MarkusLoew/OzFluxtowerhandbook/README.md

# OzFlux tower handbook
A technical guide on setting up an eddy covariance tower
