MarkusLoew/OzFluxtowerhandbook/Communication.md

# Communication

## Direct communication with a data logger

In the simplest case, communication with a logger can be done directly, by connecting a computer to the logger and downloading the data and uploading/changing programs and settings manually. This method is straightforward but requires physical access to the logger.

### Serial communication

Many modern computers don't have a serial port any more, so a USB-to-serial adapter is required. Recommended serial-to-usb adapter (known to also allow complex serial operations like firmware upgrades of a Li6400):

[FTDI Chip model US232R-10 usb to RS232](https://ftdichip.com/products/us232r-10-bulk/)

Available via e.g.

-   [recommended FTDI Chip RS232 USB to serial converter, RS-online](https://au.rs-online.com/web/p/interface-adapters-converters/0429274)

-   [Li-COR USB-to-serial connector](https://shop.licor.com/env/store/product?c=photoextra&n=6400-27)

After connecting the converter to your computer, check your computer settings what serial port the adapter is using (e.g. COM7). Windows: check "`Device manager`", section "ports" Windows port-assignments can change depending on where the converter is plugged in. For Linux: check `ls /dev/tty*` for new devices e.g. `ttyUSB0` or `ttyACM0`.

The newer generation Campbell Scientific (CR310, CR6, CR1000x) and other manufacturer's loggers have built in USB-to-serial converters. No dedicated serial cable and plug are required for those, a USB cable is sufficient to connect. The communication protocol is still RS232 and it is still required to know what serial port on the computer side is used for communication.

Li-Cor uses a null-modem / cross-over cable to communicate with their devices, while Campbell Scientific uses a straight-through serial cable. These cables are not compatible!

![Varius serial cables: Campbell Scientifc-compatible serial cable with FTDI US232R-10 USB-to-serial converter (grey cable, blue white USB-to-serial converter), Li-Cor-compatible Null-modem serial cable with self-made serial LI-7500 irga serial adapter cable (light grey, green plug). USB cables with USB-A to USB-Micro A (black, suits CR6, CR310, CR1000x) and USB-A to USB-C (white, suits CR1000xe). CR1000 data logger with serial port only. CR310 data logger with serial port, USB-MicroA port, and ethernet plug (Markus Loew).](images/communication/communication_serial_cables.jpg)

-   Campbell-Scientific-compatible *straight-through* *serial cable* for Campbell Scientific loggers and instruments, CR1000, CR3000, CR310, CR10x, ... e.g.: [Male D-Sub 9-Pin to Female Serial Cable](https://au.rs-online.com/web/p/serial-cables/1828782)

-   Li-Cor compatible *null-modem / cross-over cable* (for e.g. Li-7500xxx, Li-6400, Li-810) [Female D-Sub 9-Pin to Female D-Sub Modem Cable](https://au.rs-online.com/web/p/serial-cables/2863537)

**The two cable types are incompatible** out of the box! The cable-internal wiring is different between the cable types, but not necessarily the plug configuration! (Also: Plug-converters exist). A null-modem cable has pins 2 and 3 swapped between the two ends of the cable. Check electrical continuity of the pins to determine the cable type!

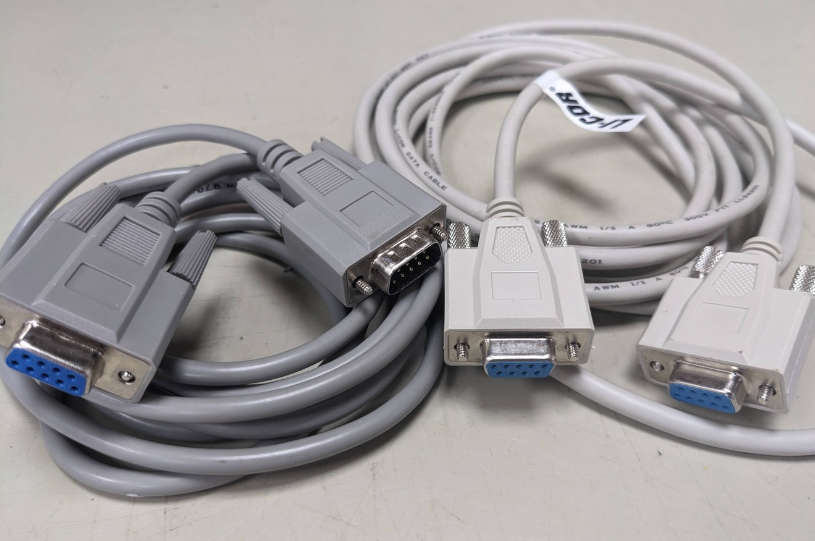
[picture p1: images/communication/serial_vs_null_modem_cable.jpg]
Serial cable for Campbell Scientific loggers, straight-through serial cable with male to female 9-pin plugs (left). Li-Cor compatible cross-over null-modem cable with female-to-female plug (right) (Markus Loew).


## Modem

If a site has reasonable 4G/5G coverage, a modem can used for data transmission [(Telstra coverage map)](https://www.telstra.com.au/coverage-networks/our-coverage). In Australia, the recommended - and frequently the only - phone network for remote locations is Telstra. TERN EP provides data-only Telstra SIM cards on request. Some towers might not require a 4G modem at all if there is an alternative internet connection (WiFi, DSL, fibreoptics, fixed-wireless, satellite, ...) readily available. Then a router will suffice (see below).

### 4G modem options

Selection criteria for modems:

-   Operating voltage: The modem must be able to operate using the available voltage(s) to avoid conversions. Many industrial modems allow 9 to 36V DC input power - Make sure the voltage of your power supply is compatible at your tower site.

-   Operating temperature: The modem must be able to operate within the anticipated temperature range of a research location. E.g. -20°C to 50°C.

-   Form factor: Chose a modem that fits in the available enclosure space, especially if all loggers and network devices must fit an a single enclosure. Modems that can be mounted vertically on a DIN rail allow to save space and use the "height" of the enclosure. Many modems offer DIN rail mounts, but some have the rail mount in a location so that it can not be installed in space-saving way. Then adapters might be required.

Recommendations for **industrial-grade modems**:

-   [Maxon Quadmax MA-6060](https://rfi-sb.rfi.com.au/MA-6060) Slim-line modem, dual SIM slots, four ethernet ports, dual 4G antennas, two WiFi antennas, DIN rail on the thin side. Has built-in analog relay to devices like e.g. phenocam. Capable to connect to OpenVPN, and similar services.

-   [Maxon Dualmax MA-2055](https://rfi-sb.rfi.com.au/MA-2055) Flat, but slightly wide modem, dual SIM slots, two ethernet ports, dual 4G antennas, no WiFi (!), DIN rail on the wide side (not space-saving out of the box, but custom angle bracket available, see below). Capable to connect to OpenVPN, and similar services. See [setup notes for this modem here](./TERNOpenVPN.md).\
    While the dualmax modem comes with a DIN-rail mount on the back, it uses quite a bit of space in an enclosure. Here is a 3D-printed angle mount that suits the 2.54 cm grid pattern of Campbell Scientific enclosures. This allows the Dualmax modem to be mounted flat or vertical to save space ([see photo](./Sensorwiring.html#wiring-information)).\
    [Download modem angle bracket mount, STL 3D print file](./downloads/Dualmax_modem_panel_mount_Loew.stl "STL file download") (Markus Loew).

-   [Robustel R1520](https://www.rfi.com.au/R1520) Wide modem, but rather small size, dual SIM slots, four ethernet ports, dual 4G antennas, WiFi, DIN rail on the wide side. Capable to connect to OpenVPN, and similar services. ***!!There are unresolved issues with this modem and the TERN OpenVPN encryption, unfortunately!!***

-   [Comset CM685V-4](https://comset.com.au/product/4g-lte-cat-4-wifi-router-with-sim-card-slot-cm685v-4/) 4G LTE Cat 4 WiFi router with SIM card slot. Quite compact form factor. This modem operates on the powerful OpenWRT OS and provides an OpenVPN client, MiMo antenna linking, 2 ethernet ports, and WiFi. Melbourne-based company.

-   [Belden Netmodule 1601](https://www.belden.com/products/industrial-networking-cybersecurity/wireless/iiot-and-industrial-routers/nb1601-lsc) Slim-line modem, dual SIM slots, four ethernet ports, dual 4G antennas, two WiFI antennas, DIN rail on the thin side. Has built-in analog relay to devices like e.g. phenocam. Capable to connect to OpenVPN, and similar services.

-   [Teltonika RUT951](https://www.telcoantennas.com.au/teltonika-rut951) Dual antenna, dual SIM modem with three ethernet ports. OpenWRT-based. BEware of the Molex 4-pin power plug! See [Teltonika power options](https://www.teltonika-networks.com/products/accessories/powering-options), [4-way Molex power plug](https://www.digikey.com.au/en/products/detail/molex/0430250400/252497), and [plug accessories](https://www.digikey.com.au/en/product-highlight/m/molex-connector/micro-fit-3-interconnect-system). The DIN rail is sold separately.

-   [Campbell Scientific Cell220](https://www.campbellsci.com.au/cell220) Serial modem well integrated the the Campbell Scientifc logger ecosystem. The Modem is conveniently configured via the logger program (CRBasic). This modem can interact directly with logger, and data and provides diagnostic output (like signal strength, uptime) to data tables on the logger. Modem actions can be triggered depending on logger or measurement status. No WiFi, no ethernet ports, dual antenna, single SIM card. Small form factor, highly configurable. Similar serial modems are available elsewhere too, as long as they support he full range of AT modem commands (ie Netmodule NB1600).

Note: As TERN EP provides **data-only SIM cards**, any monitoring and feedback-options of the modems that rely on SMS text messages will not work! There is no "phone" quota associated to these SIM cards. E.g. the Quadmax modem can not send a warning SMS when switching from primary to the secondary SIM card when the primary card fails! And any IP-address monitoring and dial-in options that these modems provide (e.g. direct dial-in in case OpenVPN fails), don't work with data-only cards either.

It is highly **recommended to set up the modems to reboot themselves regularly!** This ensures that the modem can recover from any temporary network issues. Network congestion can be temporary: holiday-makers in a nearby campsite or a music festival in the area of the tower can "overload" the 4G network, or the Telstra-network tower can be offline for maintenance. Once these issues are resolved, the tower will be come back online by itself after the next reboot. After a 4G network outage, not all modems keep trying to re-connect to the network. E.g. the Maxon modems only try five times and then then stop. Re-booting the modem resets this counter and the modem will connect again. Hence, set up scheduled reboot either daily or weekly. Set a conventient time of day that does not interfere with data collection or other critical operations.

From experience with **operating towers in bad or sometimes congested mobile phone networks** (Whroo, Boolcoomatta), the modem can come back online for at least a few minutes after an automated reboot even in a low bandwidth or congested situation before the connection drops out again. If the daily (or weekly) reboot is scheduled at a time with less network congestion (night time, weekend), the modem might be online again, at least temporarily. This allows to check on signal strength in the modem (to see if the antenna might be damaged, cable broken, ...), and allows to check logger program settings, or delete faulty files from the storage card.

Turning off the upload of 10/20 Hz flux data can help "clean the airwaves" to allow the much smaller 30 min average data tables to be uploaded despite congestion. A specific logger program for low bandwidth situations is available as the *Boolcoomatta logger program* (Markus Loew) from [OzFlux logger code repository](https://github.com/OzFlux/logger_code) (Ian McHugh). This program has options in the *Public* table to change the upload format of the 10/20 Hz data (choice between compressed, small TOB1 files, or ASCII, easy-readable but uncompressed TOA5 files.) And it allows to not upload the fast data at all to save bandwidth and upload time. Having these options in the *Public* table allows to change file- and upload-related settings without risking sending a new program over a bad internet connection.

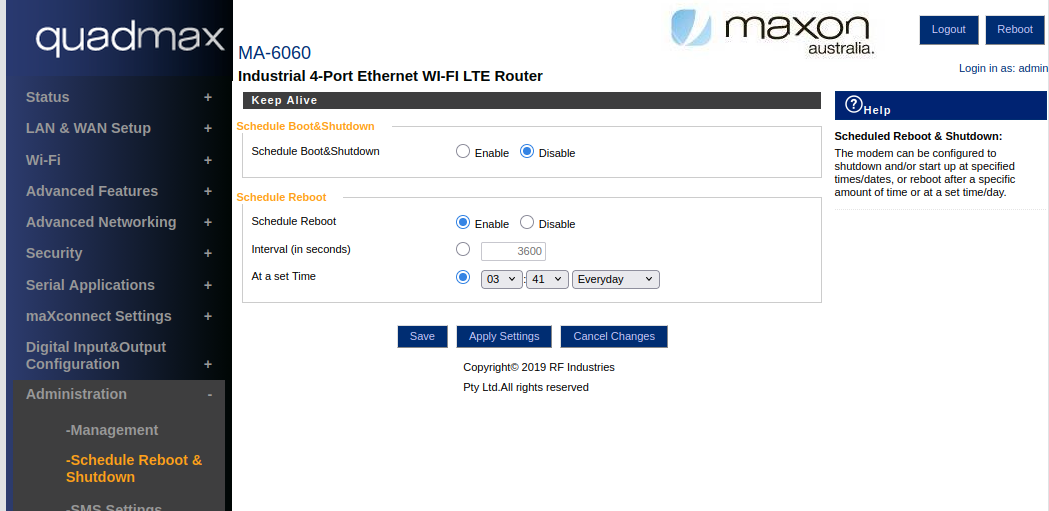
[picture p2: images/communication/modem_regular_reboot.png]
Schedule reboot options in the settings of a Maxon Quadmax modem. The modem will reboot itself every day at 03:41 (Markus Loew).


### Antennas

-   **Omnidirectional** (omni) antennas are "install and forget": they will connect to any phone network in the area, and can switch between multiple network towers depending on signal strength or if a phone tower goes offline.

-   **Directional** (yagi) antennas must be pointing to a known, specific network tower. This will improve the signal. The downside is, that the antenna points to a single tower. If that one network tower goes down, this antenna will not be able to connect to another tower.

In locations with marginal reception, it is recommended to use a modem that allows the use of **two antennas, preferably yagi, in parallel (MiMo)**. Both antennas must be pointing to the same phone network tower (!), and must be about 50 cm apart vertically for optimal signal boost.

-   [BlackHawk Directional antenna, MiMo capable](https://blackhawkantennas.com.au/product/blackhawk-lpda-antenna/) You need two of these antennas for MiMo operation!
-   [Comset Directional antenna, 4x Yagi antenna MiMo capable](https://comset.com.au/product/5g-mimo-4x4-lpda-antenna-3g4g5g-10-m-ant-yagi-4x4-10sp/)
-   [Phased Array Yagi Kit](https://www.telcoantennas.com.au/ultimate-antenna-kit-19dbi-rfi-phased-yagis) for maximum distance.
-   [ZCG Scalar directional antenna](https://zcg.com.au/product/broadband-uhf-4g-lte-and-dualband-4g-log-periodic-antenna-304-stainless-steel-650-2250-mhz-250w-n-type-female-10-2-dbi-1-15m-4/)
-   [ZCG Various antenna mounts](https://zcg.com.au/catalogue/mobile-vehicle-mount/)

When designing the tower and instrumentation location on the tower, keep in mind that **standard antenna cables can only be 10 m long** before significant signal degradation occurs. Hence, the modem must be close to the antenna! See section anttenna cable length limitation below.

### Antenna cable length limitation

Cables between a 4G modem and a 4G antenna should not be longer than 10 m! Longer cables can cause significant (logarithmic?) signal degradation, reducing the effectiveness of the antenna setup. For tall towers, this means that the modem must be on top of the tower, out of reach of easy access, to be close to the antenna. This can be a problem for maintenance and troubleshooting. For towers up to 10 m tall, the modem can be inside the data logger and power enclosure (see e.g. Boolcoomatta tower) making it a compact and accessible setup.

If a \<10 m modem cable is not an option at all:

For **longer antenna-to-modem distances**, beyond 10 m, but less than 30 m, one could try a eg [Ultra Low Loss Flexible Coaxial Cable](https://www.telcoantennas.com.au/telco-antennas-lcu600-ultra-low-loss-flexible-coax~87862).

### Check for available towers in your area on these websites:

-   [RFNSA Radio Frequency National Site Archive](https://www.rfnsa.com.au/)

-   [ACMA map](https://web.acma.gov.au/rrl/site_proximity.main_page)

-   [Ausphonetowers](https://ausphonetowers.com.au/)

To determine line of sight between a phone tower and your location:

-   [Hey What's That (Line of sight map, panorama)](https://www.heywhatsthat.com/)
-   [Incoherency Line of Sight Map](https://incoherency.co.uk/line-of-sight-map/)
-   [Scadacore RF Line of Sight](https://www.scadacore.com/tools/rf-path/rf-line-of-sight/)

Phone apps to check signal status and cell tower locations:

-   [SignalStrength App](https://play.google.com/store/apps/details?id=com.cls.networkwidget&hl=en_AU)

-   [Opensignal apps](https://www.opensignal.com/apps) Opensignal seems to use community sourced phone tower locations. The websites listed above provide a more comprehensive list of towers.

#### Checking and optimising 4G connectivity, antenna direction

Neither of the above antenna-map websites can guarantee that there will be reception at the location! A fieldtrip with modem and antenna(s) and a long pole is usually required to check connectivity. If there is marginal 4G coverage, it is about optimising the available signal.

Check signal strength:

-   4G signal strength is measured in decibel, dB(m). For details on RSSI, RSRQ, RSRP, and SINR metrics see: <https://wiki.teltonika-networks.com/view/Mobile_Signal_Strength_Recommendations>

-   The tested modems above display the 4G signal strength in their "Status" or "WAN" management website. This is commonly named "RSSI" and displayed in dB(m). Less negative RSSI values indicate higher signal strength in general. For caveats regarding RSSI see <https://wiki.teltonika-networks.com/view/Mobile_Signal_Strength_Recommendations>

-   Phones can be used as a quick way to check connectivity, Apps like "Signalstrength" give more details than the usual "number of bars". However, the physically small internal antennas are no match for dual, directional antennas! It is possible to establish a well working connection with largeer antennas when a phone shows zero "bars". Size matters!

-   Use two antennas in MiMo mode. This can boost signal strenght by 30 to 50% from experience (Note that the RSSI scale is logarithmic). \* Point the antennas in the direction of known phone towers (use the websites listed above to see maps of available towers). Wait for about one to three minutes and check the signal strength RSSI values displayed in your modem management interface. Then turn the antenna to sweep for a better / worse signal.

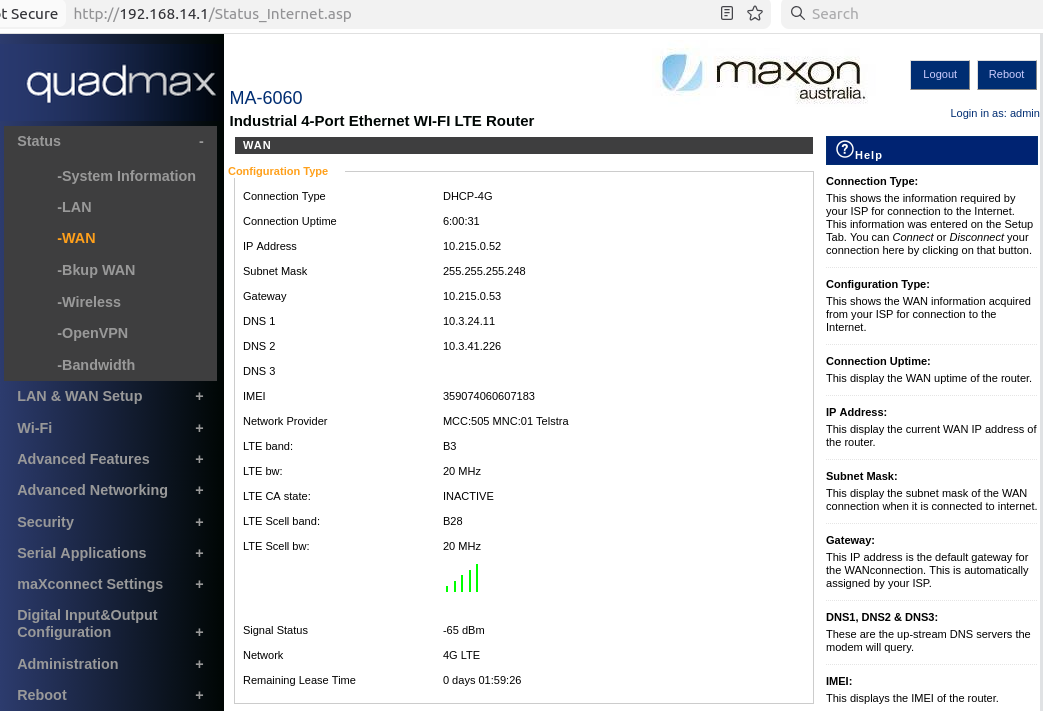
[picture p3: images/communication/Quadmax_signal_strength_screenshot_from_2026-04-10 09-18-24.png]
4G WAN status display of a Maxon Quadmax modem. See "Signal Status" of -65 dBm indicating good reception. This modem uses dual directional antennas. With a single, omnidirectional antenna, the signal strength at this tower was only marginal at -85 dBm (Markus Loew).


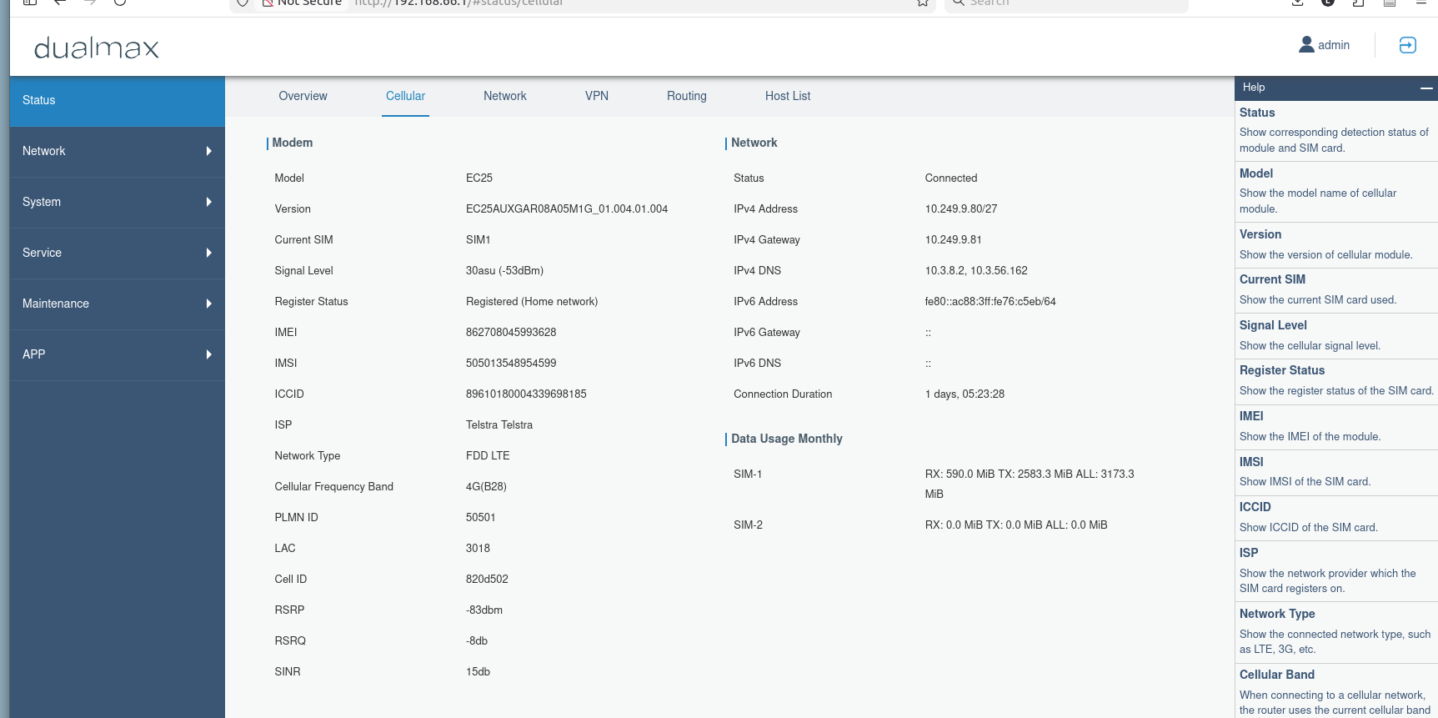
[picture p4: images/communication/Dualmax_signal_strength_screenshot_from_2026-04-10 09-19-27.png]
4G cellular status display of a Maxon Dualmax modem. Signal level of -53 dBm indicates an excellent signal status. This modem uses two small "indoor" antennas inside the enclosure. The tower is in a location with general good 4G network coverage, no large outdoor antennas are needed.


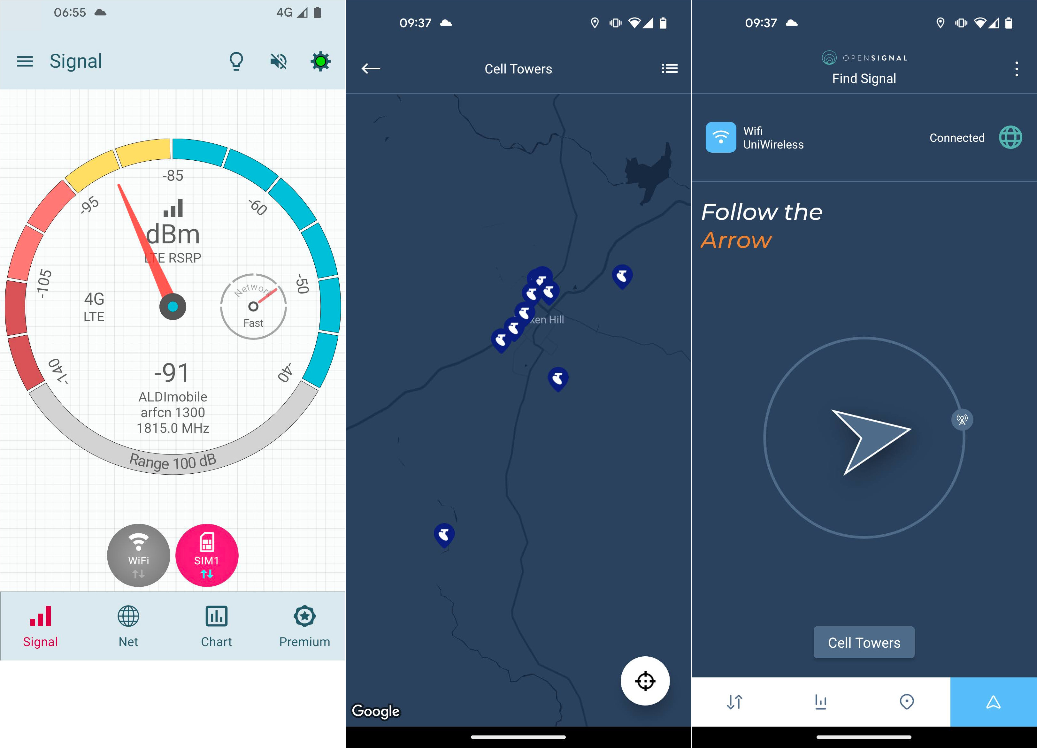
[picture p5: images/communication/signal_strength.jpg]
Signal strength display and tower location displays from two phone apps: "SignalStrength" (left), indicating marginal 4G reception and showing an overall classification of the the 4G signal strength range. Location of 4G towers mapped by the app "Opensignal" (middle), and direction indicator of the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


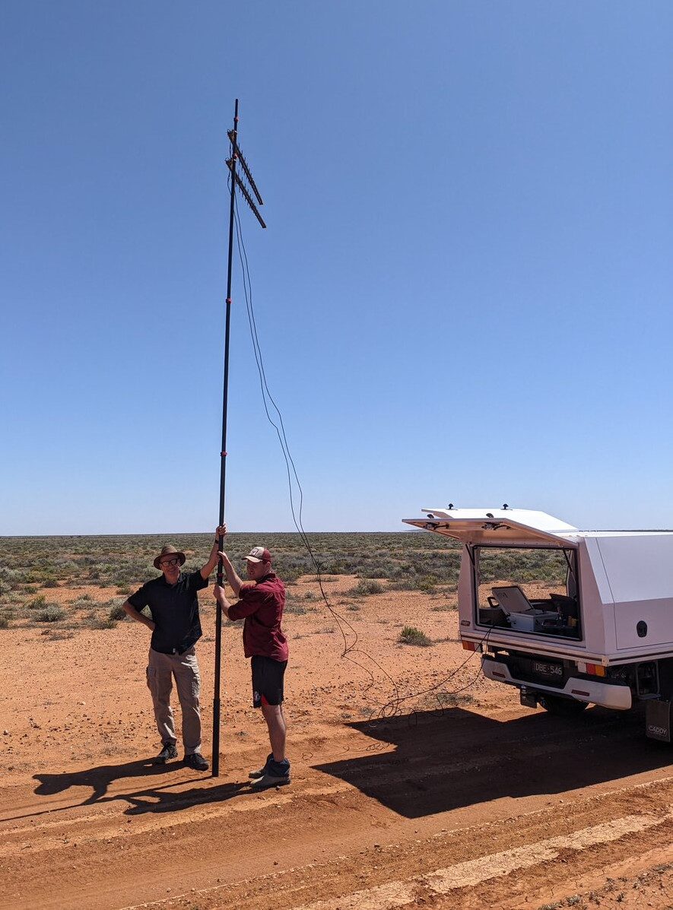
[picture p6: images/communication/checking_for_connectivity.jpg]
Checking and mapping 4G connectivity on location months before deciding on a location for the flux tower. Two directional mimo antennas on a telescopic pruning pole connected to a battery-powered Maxon Quadmax modem were used to test mobile network reception and data transmission bandwidth. A good 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


## Satellite communication

to do (Mark Hovenden?)

-   12V Starlink Mini

-   240V Starlink either via inverter or via 12V modification, POE injector? see below [Communication.html#poe-injectors](./Communication.html#poe-injectors)?

-   how to do TERN OpenVPN via limited, locked-down Starlink router? Daisy-chain quadmax-modem/router or similar behind Starlink router?

-   Power consumption during transmission?

-   Constant connectivity? Or interrupted depending on satellite availability, rain, leaves? Problem with disconnects?

## Router

Check if a modem provides sufficient ethernet ports (router functionality) for all the devices on the local tower network. Consider a modem with sufficient built-in ethernet ports. Avoid "office-grade" network routers. Check if what data transmission rates are required at a research tower. Chose a GBit capable-router if required (ie for high-frequency spectral data or similar high-volume data acquisition). Many industrial MBit-class routers offer sufficient performance for flux-related data transfer and are more robust.

### Router recommendations

Unmanaged-routers:

-   [Industrial 5-port 100 MBit router](https://www.brainboxes.com/product/industrial-ethernet-switches/fast-ethernet/sw-505) (5 to 30V, DIN rail mount)

-   [Industrial 8-port 100 MBit router](https://www.brainboxes.com/product/industrial-ethernet-switches/fast-ethernet/sw-508) (5 to 30V, DIN rail mount)

-   to do: recommendation for GBit networks?

General network routers like office-grade, indoor routers (e.g. Netgear) are known to be more susceptible to electrical interference (lightning, power surges) and do not operate well at extreme temperatures compared to "industrial" routers.

## Power over ethernet (POE) injectors

Some network devices like WiFi extenders, some phenocams, (Starlink?), require power-over-ethernet. This provides the power to operate the device via the ethernet cable.

As ethernet cables have a tiny diameter, voltage is boosted by the POE injector to cover large distances without voltage drop.

Some large POE-powered devices like the UniFi Outdoor 7 WiFi hub require POE+, ie 56V, to operate!

Be aware of power demands: The conversion from 12V to 48V or even 56V to operate a POE device is quite power-consuming.

Recommended 12V-operated POE injectors (<https://www.telcoantennas.com.au/>):

-   [POE 12V to 48V](https://www.telcoantennas.com.au/12vdc-to-48vdc-poe-passive-power-over-ethernet-inj)

-   [POE+ 12V to 56V](https://www.telcoantennas.com.au/12vdc-to-56vdc-poe-power-over-ethernet-injector)

## WiFi extenders

-   [UniFi AC Mesh](https://techspecs.ui.com/unifi/wifi/uap-ac-mesh?) Despite the name, it is powered by via POE. But it includes an injector for a 240V AC household outlet.
-   [TPlink EAP225 Outdoor](https://www.omadanetworks.com/au/business-networking/omada-wifi-outdoor/eap225-outdoor/)

There are stark similarities between the two models above.

[Home](./Home.html)
