MarkusLoew/OzFluxtowerhandbook/Phenocam.md

---
bibliography: ./references/References.bib # path and bibliography .bib file name
---

# Phenocams

## Phenocam models

### Campbell Scientific CCFC

Across the TERN OzFlux network, many sites are equipped with the [Campbell Scientific CCFC camera](https://www.campbellsci.com/ccfc).

This camera integrates well with the TERN network as it supports key-based sftp file upload via ssh to the TERN file storage and data portal automatically. It is extremely well built, it is its own wheaterproof housing, has a deep-sleep power mode of \< 6 mA, large built-in file storage, and has a simple configuration web interface. But it is rather expensive!

It is the **preferred model** for TERN-supported flux towers to ensure standardisation.

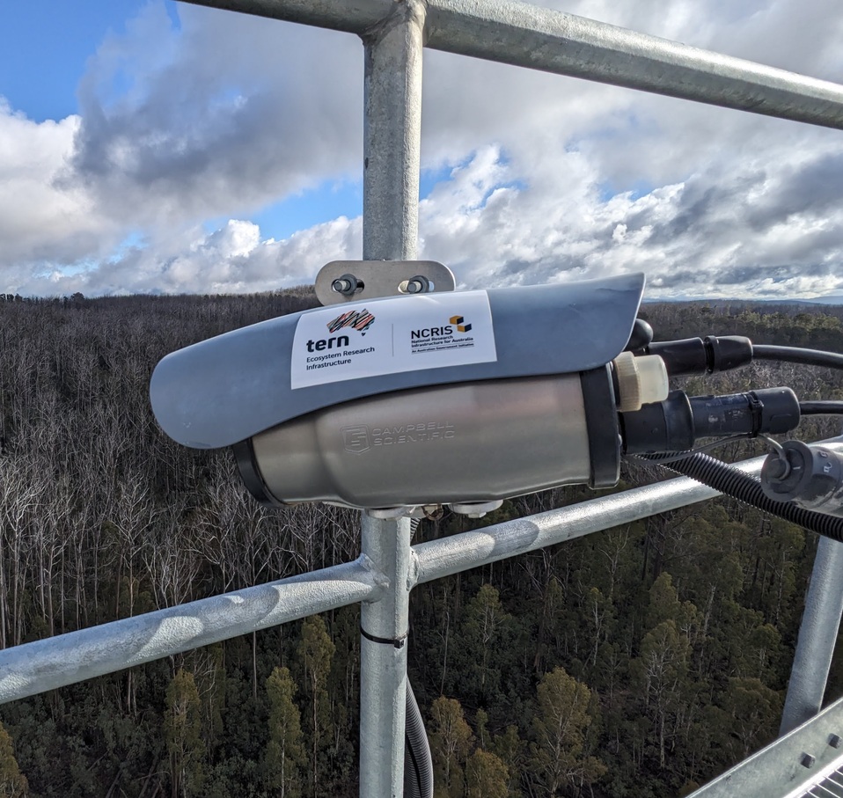
[picture p7: images/phenocam/Campbell_Scientific_CCFC_PXL_20260611_002924827.jpg]
Campbell Scientific CCFC phenocam on the Tumbarumba tower (Markus Loew). Custom mounting bracket provided by Nico Weigand.


In addition to the usual visible light photo, the camera provides NDVI images directly. Or it can be set up to take visible light, NDVI, and an IR image. Default for TERN for this camera is to provide the visible light photo and the NDVI image.

The CCFC uses a weatherproof ethernet cable (10 m) for communication and a separate power cable for 9 to 30 V. Settings and live images can be accessed via the built-in WiFi network.

An external trigger can be used (e.g. via a relay as available in the Maxon Quadmax modem or a control port on a Campbell Scientific logger) to wake the camera from deep sleep via a 12V signal.

The camera is fully integrated into the Campbell Scientific sensor network and can interact with dataloggers and Loggernet via Pakbus.

To mount the camera on a pole, the bracket [18549 ACC CC Camera or PWD22 Mounting Kit](https://www.campbellsci.com/order/p18549) is required. Alternatively, Nico provides a custom built, versatile mount for the CCFC (or provides the CAD drawings to manufacture it yourself).

Ensure the camera has the latest firmware installed! Because: Older firmware versions do not add a colour scale to the NDVI images - this makes it difficult to interpret NDVI images across the network.

#### Data upload to TERN from a Campbell Scientific CCFC camera

A generic configuration file to enable taking scheduled photos, file names, and upload setting is available for download [here (CCFC XML configuration file)](./downloads/CCFC-9999-20260723_generic.xml) (Use the right-click `Save link as` option in your browser to download this XML file instead of displaying it!). After loading this generic configuration file onto the camera via `Settings/Advanced/Upload configuration` in the CCFC web interface, adjust the camera name (usually similar to `CCFC-xxxx`), site name (`AU-Xxx`), time zone, and WiFi access point password, etc to suit your camera.

The camera provides a ssh key in its web interface. Send this key to TERN (Gerhard) via keybase file transfer. Ask Gerhard or TERN support (esupport\@tern.org.au) for account details for file upload.

### Stardot Netcam Live 2

A cheaper alternative to the Campbell Scientific CCFC is the Stardot [Netcam Live 2 camera](http://stardot.com/netcamlive) (StarDot Technologies, Buena Park, CA, USA). For camera details and a performance review of the Netcam live 2 camera compared to the previous model see @javadian_continuity_2025.

The camera does not have a deep sleep mode, it is always on! It uses about 400 mAh\@12V of power as stated by the manufacturer. As tested, for taking occasional photos, the constant power consumption (while idle) is just below 200 mAh\@12V. Power (between 10 to 20V DC) is provided either via a 12V barrel jack, or via POE. To save power at tower sites with limited energy availability, the power to the netcam live 2 would need to be switched off physically via a scheduled / programmed relay.

The Stardot [Knowledge base for the Netcam Live2 camera is available here](https://stardot-kb.netlify.app/kb/files/).

**This camera does not capture NDVI images directly, but provides separate visible light (RGB) and IR images to calculate NDVI off-camera!**

NDVI can later be calculated as `NDVI = (NIR - Red) / (NIR + Red)` from the corresponding RGB and IR images.

The weatherproof housing and mounting arm must be ordered additionally: [Compact Outdoor Enclosure with Wall Mount Enc-Outd3](http://stardot.com/products/compact-outdoor-enclosure). The wall-mount arm of the outdoor enclosure needs to be modified slightly to install it on a round pole (50 mm OD pipe) on a tower: The upper holes in the wall mount can be opened up further. Then use a clamp, e.g. a [C9 2⅛" exhaust clamp](https://autobarn.com.au/ab/Autobarn-Category/Shop-our-Full-Range-by-Brand-at-Autobarn/Walker/Walker-Exhaust-Clamp-54mm-2-1-8in---C09P-1-/p/SP00895) (or from a nuts and bolts shop), to adapt the flat mount to a pole mount, and use a second C9 clamp with a brace for additional rigidity. A U-bolt as provided by Campbell Scientific can be used as well.

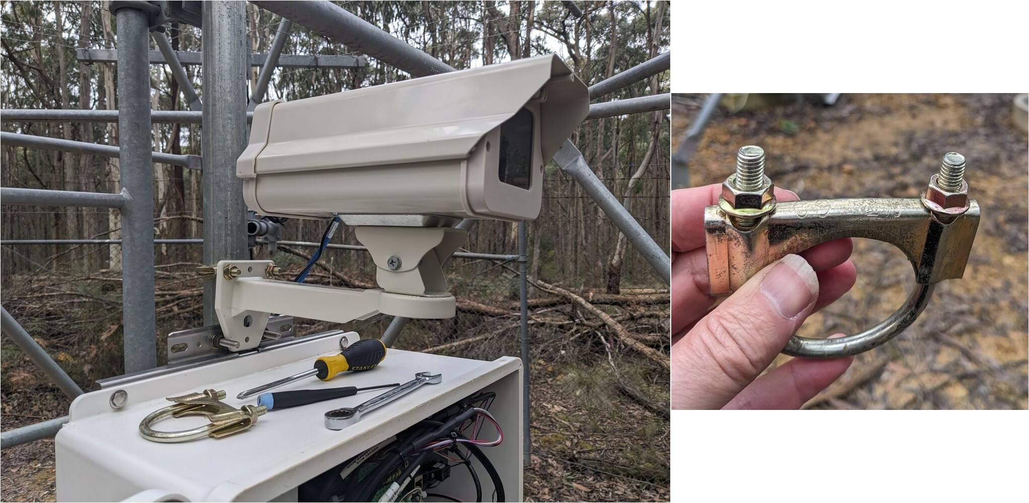
[picture p8: images/phenocam/Stardot_phenocam_enclosure_and_bracket.jpg]
Stardot Netcam Live2 test install (left) and C9 clamp (right). Photo: Markus Loew.


The cable gland provided with the outdoor enclosure by Stardot does not suit the combined power and ethernet cable that Stardot provides. See [Split Glands section](Enclosures.md) for a weatherproof solution.

For detailed setup instructions for this camera, albeit for the international phenocam network, not the TERN data portal, see [Phenocam network Netcam Live 2 install instructions](https://phenocam.nau.edu/pdf/PhenoCam_Install_Instructions.pdf).

#### Software to upload images from the Netcam live2 camera to TERN:

See [the netcamTERN upload software repository (Markus Loew)](https://github.com/MarkusLoew/netcamTERNupload) regarding uploading photos to TERN automatically.

### AXIS cameras

Other camera options are

-   [Axis P1487-LE Bullet camera](https://www.axis.com/products/axis-p1487-le) (Older model as used within the OzFlux network was [Axis P1467-LE camera](https://www.axis.com/products/axis-p1467-le/support) )

-   [Axis P1488-LE Bullet Camera](https://www.axis.com/products/axis-p1488-le) (Older model as used within the OzFlux network was [Axis P1468-LE Bullet Camera](https://www.axis.com/products/axis-p1468-le/support))

-   [AXIS P3747-PLVE Panoramic Camera](https://www.axis.com/products/axis-p3747-plve) 

Axis cameras use POE for power (\~4W constant power draw). Use "hanger bolts" to install cameras on trees: M6 metric thread on one side and a wood thread on the other, e.g. [Bunnings Hanger bolts](https://www.bunnings.com.au/everhang-m6-x-48mm-zinc-plated-hanger-bolt-4-pack_p2310854)

### ReoLink

-   [Reolink Argus PT Ultra](https://reolink.com/au/product/argus-pt-ultra/) (a model with WiFi and solar panel available - but this model does not have automatic ftp upload, though)

## General protocol for TERN phenocams and manual image upload

See the upload paths on UQ RDM and the TERN naming conventions in the Knoweldge Base at: <https://ternaus.atlassian.net/wiki/spaces/TERNSup/pages/2629730756/Phenocam>

The camera models listed above all allow changing the filename of the photos to match the pattern expected by TERN.

Images get uploaded to UQ RDM file storage via sftp. Or, if the camera is within the TERN OpenVPN network, ftp upload is an option (check with TERN support for ftp server details - esupport\@tern.org.au).

The images get ingested into the TERN data portal within 24 hours and are then removed from UQ RDM.
