MarkusLoew/OzFluxtowerhandbook/Enclosures.md

# Enclosures

## Commercial enclosures

### Fibreglass

Fibreglass enclosures are the default for instruments from Licor and Campbell Scientific. These are relatively lightweight and come with attachments to suit towers and poles. In the case of enclosures from Campbell Scientific, their included peg-board mount fits they data logger and accessories.\
Long-term, fibreglass enclosures degrade to varying extent due to sun/UV exposure. They can delaminate. and become brittle. Delamination can happen within one year, but might not happen after several years. Custom shade covers are recommended in some areas (see below).

-   [Options for Campbell Scientific enclosures (fibreglass and steel)](https://www.campbellsci.com.au/enclosures)

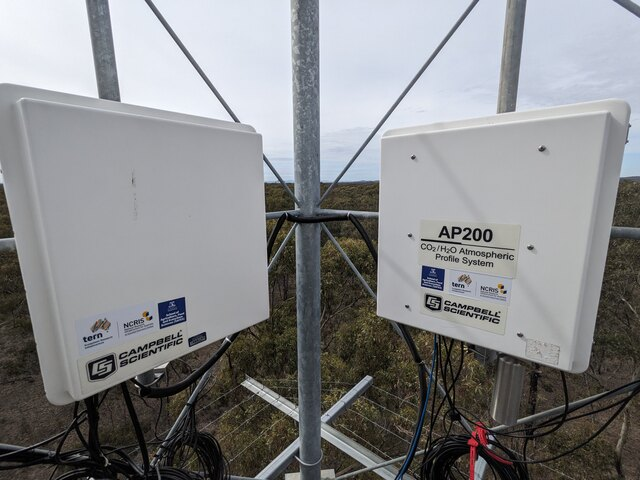
[picture p10: images/Whroo_enclosures_PXL_20251112_225153611.jpg]
Fibreglass enclosures in the field after several years (left) and one year (right) (Markus Loew)


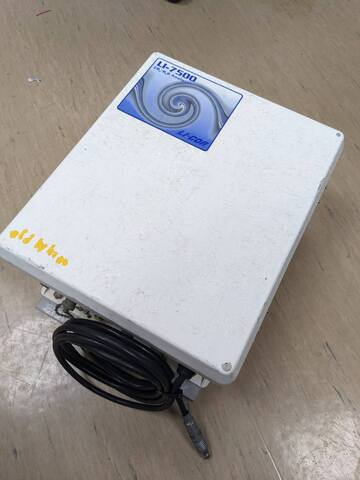
[picture p11: images/Fibreglass_enclosure_Licor_PXL_20251127_213731136.jpg]
Delaminating fibreglass enclosure, Licor (Markus Loew)


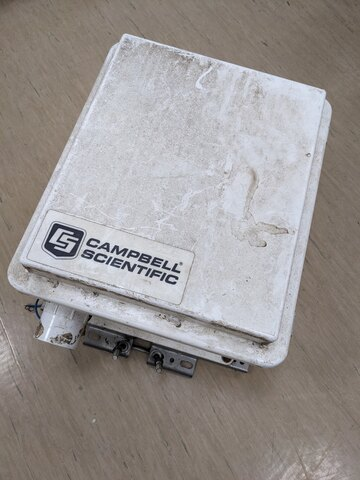
[picture p12: images/Fibreglass_enclsoure_Campbell_PXL_20251127_213846954.jpg]
Fibreglass enclosure after many years in the field, without delamination (Markus Loew)


### Metal

Metal enclosures are standard in many electrical installations. They are not always best for flux towers, though. Metal enclosures with plastic locks or other parts fail similarly to fibreglass enclosures as the UV degrades the plastic parts.\
Working with steel enclosures can be difficult to drill into to install cabling, and they can rust. The weight of steel enclosures can make install on tower more difficult.\
Aluminium enclosures can be too flimsy for long-term use in the field, depending on type. A big downside of aluminium is heat buildup inside. A sun cover is recommended depending on location.

-   In general, check the quality of hinges, locks, and ensure that water can not pool on top of the seals of the enclosure. Ensure good grounding / earth protection for metal enclosures!

-   If vandalism or theft is a possibility at the tower location, consider heavy duty enclosure or add additional protection around the instrumentation via a cover (see below)

-   Suppliers of enclosures\
    [IP Enclosures](https://www.ipenclosures.com.au/aluminium-electrical-enclosures/)\
    [Delvallebox](https://www.delvallebox.com/en/aluminium-electrical-enclosures/aluminium-wall-enclosure-ip66-luxor) see their NEMA steel series\
    [Tropac enclosures (untested)](https://www.tropac.com.au/enclosures)\
    [Campbell Scientific enclosures (fibreglass and steel)](https://www.campbellsci.com.au/enclosures)

## DIY enclosures and shade covers

Better protection in harsh environments from wildlife, and weather. Matt Northwood built custom structures that protect the enclosures from ants, provides sun protection for the enclosures inside and for people working in the instruments, improved protection from wildfire and weather, increased security.

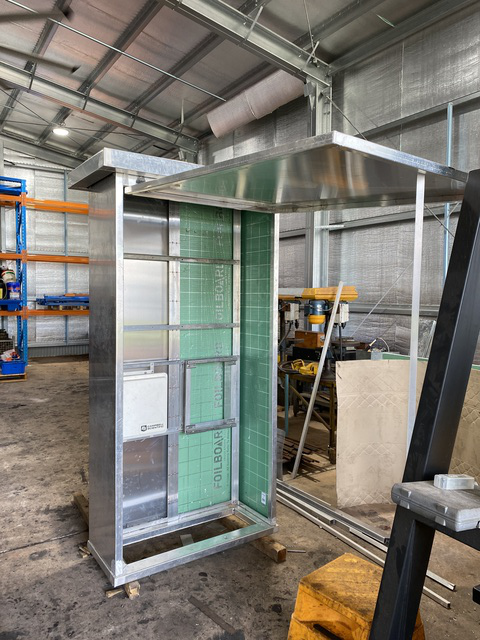
[picture p13: images/Matt_monolith_image002.jpg]
DIY protective structure for enclosures (Matt Northwood)


-   Shade cover\
    Custom cover to fit over enclosure:\

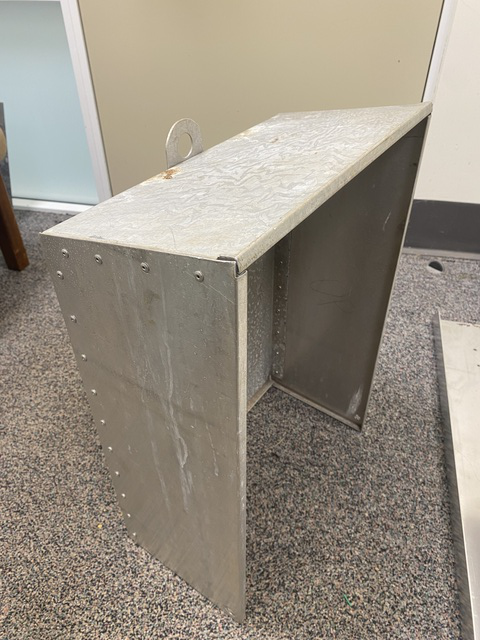
[picture p14: images/Matt_shade_cover_image004.jpg]
Custom shade cover for enclosure (Matt Northwood)
\
Custom shade cover for a Campbell Scientific fibreglass enclosure (Matt Northwood)

# Cable glands, waterproof cable entry into enclosures

## Glands sealed with putty

The simplest way to feed cables into an enclosure is a simple hole with protective pipe. Once the cables are installed, the hole is sealed with electrical putty against water ingress and wildlife.\

-   This is not a perfect seal as insects and water will still get in! And the electrical putty becomes brittle over time. Still, it is a simple and fast way to install cables. Campbell Scientific enclosures use this system by default. Such electrical putty is hard to find in Australia (?). Campbell Scientific provides electrical putty with their enclosures.
-   [LAPP Australia Cable glands](https://lappaustralia.com.au/en/nylon-cable-glands)
-   [Prysmian R391 Electrical Weatherproof Compound, Supplier 1](https://www.swiftsupplies.com.au/r391-weatherproof-electrical-putty-500gm-kit)
-   [Prysmian R391 Electrical Weatherproof Compound, Supplier 2](https://www.connectionsolutions.com.au/product/prysmian-bicon-r391-electrical-weatherproof-compound/)

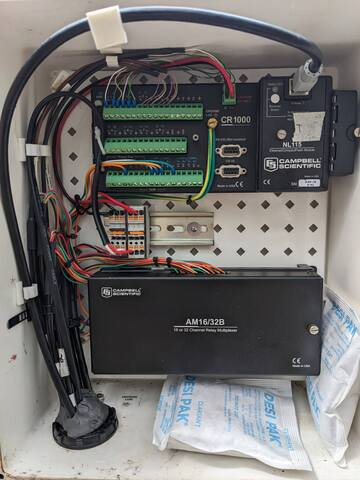
[picture p15: images/Wombat_soil_enclosure_putty_PXL_20251023_034123598.jpg]
Campbell Scientific enclosure with simple cable access and electrical putty as seal (Markus Loew)


### Glands with multi-hole inserts

Multi-hole inserts provide a better seal around the cables than the electrical putty shown above.

-   Installing and removing cables is not as easy compared to the other methods, especially if there are plugs at the end.

-   these inserts provide excellent cable management, though.

-   [Lapp Australia Multi-Hole inserts](https://lappaustralia.com.au/en/multi-hole-inserts)

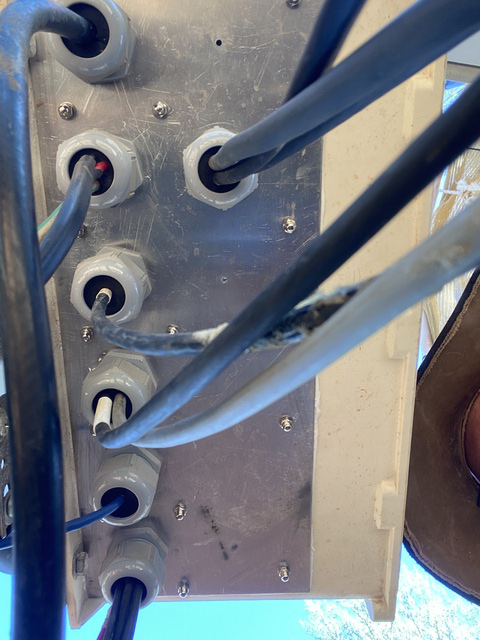
[picture p16: images/Matt_Northwood_glands_IMG_1136.jpg]
Nylon cable glands with multi-hole inserts (Matt Northwood)


### Lapp skintop cubes and Icotek cable entry systems

An alternative to cable glands are *Lapp skintop cubes* or *Icotek cable entry systems*. A rectangular frame is installed into the enclosure wall. This frame holds eight to ten inserts that surround individual cables entering the enclosure.

-   as each cable has it's own insert, individual cables can be easily removed / inserted. This becomes handy when wires need replacing or when installing cables with plug at the end, like e.g. ethernet cables.

-   relative expensive

-   the Skintop inserts are initially difficult the remove from the cables! This can be frustrating on location. After re-opening them once or twice, though, they can be opened without tools while still being watertight afterwards.\
    The Icotek system uses bolts to take the frame apart making the system easier to use on location. But all elements are released and some elements might fall apart when the frame is open - be careful on top of a tower.

-   [Lapp Skintop Cubes](https://lappaustralia.com.au/en/skintop-cube-frames)

-   [Icotek split cable entry systems for cables with connectors](https://www.icotek.com/en/products/cable-entry-systems)

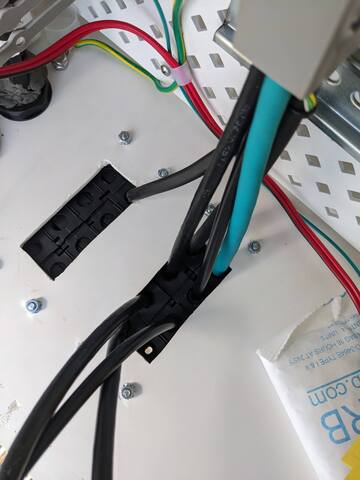
[picture p17: images/Skintop_glands_PXL_20250324_042148966.jpg]
Skintop multi-cable insert with blank inserts for future cables on the left and inserts with cables on the right (Markus Loew)


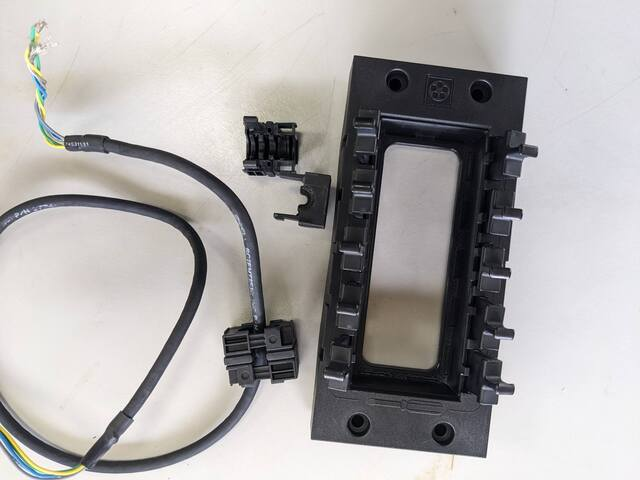
[picture p18: images/Skintop_cube_frame_PXL_20251127_232808077.jpg]
Skintop cube frame and inserts (Markus Loew)


### Split glands

A cheaper alternative and a mixture of cable gland and cable entry system are split cable glands - if the plug fits through the gland.

[Icotek split cable glands](https://www.icotek.com/en/products/cable-glands/qvt)

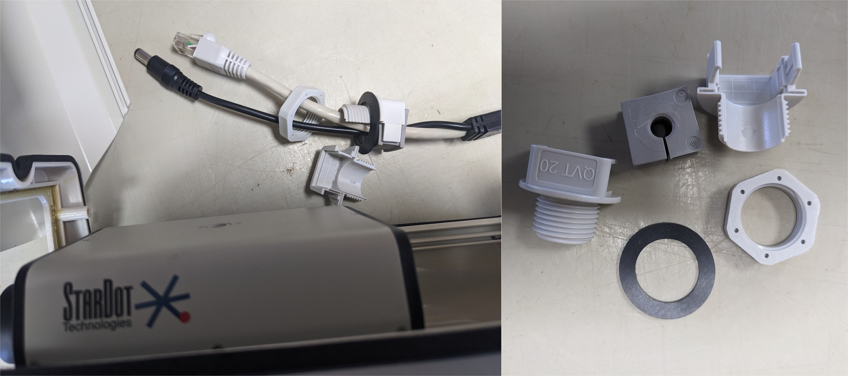
[picture p19: images/enclosure/Split_gland.jpg]
Icotek compact split cable gland QVT. Left: Split gland used to feed the combined network and power cable into the outdoor enclosure of the [Stardot NetcamLive2 camera](Phenocam.html#stardot-netcam-live-2). Right: detailed view of a Icotek QVT split gland. (Markus Loew)


[Home](./Home.html)
