MarkusLoew/OzFluxtowerhandbook/Towers.md

---
bibliography: ./references/References.bib # path and bibliography .bib file name
---

# Tower types

## Tower size considerations

From @aubinet_eddy_2012:

“Tower size (horizontal dimensions, not height) shall be large enough to be **safe and secure** for many years of operation, but should also limit the impact on the surrounding environment and scientific measurements of interest and minimize the flow distortion” \[...\]

“Large tower structures create larger canopy openings, which promote wind recirculation \[...\], enforcing **chimney effect**, changing the local microclimate, and, for the biological concerns, introducing opportunistic plant species, which will locally alter ecosystem structure around tower due to the radiation and temperature changes at the opening (edge effects).” \[...\]

“As a general guideline for tower design and establishment, **the spacing between tower and nearby trees should mimic the existing mean distance between trees** (i.e., mimicking the existing natural ecosystem structures and openings).”

## Single pole towers

Very small distortion to the environment, but single pole tower need a foundation for the pole and potentially guy wires to avoid movement, especially avoiding resonance at some windspeeds. This tower type is cheap to build, easy to install without disturbing the environment. The access to the sensors is via a portable ladder.

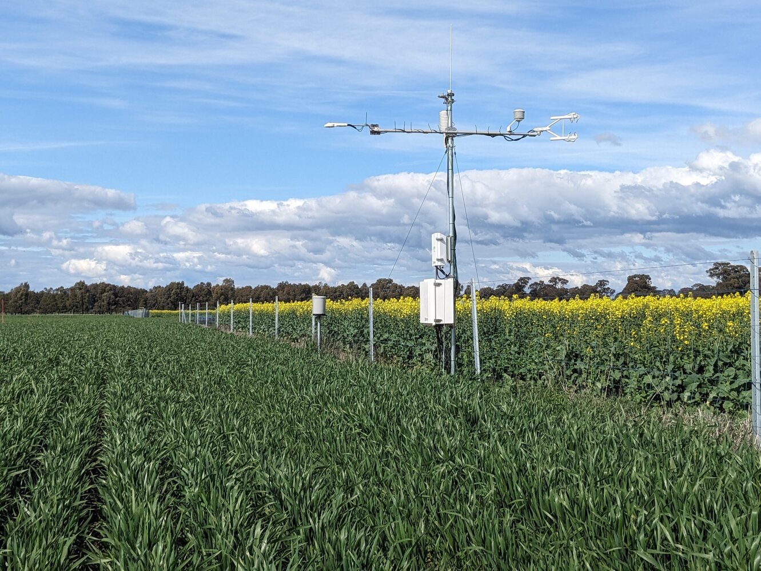
[picture p28: images/tower_types/Dookie_single_pole_PXL_20250902_034506670.jpg]
One of the Dookie towers, second season of operation: single pole tower (48 mm OD pole 4 m long, 1 m set in ground in concrete foundation) to allow machinery to get close to the tower. Steep guy wires (Markus Loew).


## Tripod towers

Such tripod towers have a maximum height up to \< 4 m. The tripod base has quite a large footprint, though. Tripods are very quick to deploy. They are easy to set up, which allows to get the tower into the ecosystem with little disturbance and can be removed without leaving much of a trace. Legs can be adjusted to allow for uneven ground.

E.g. Campbell Scientific: [CM106B-CSA](https://www.campbellsci.com.au/cm106b-csa)

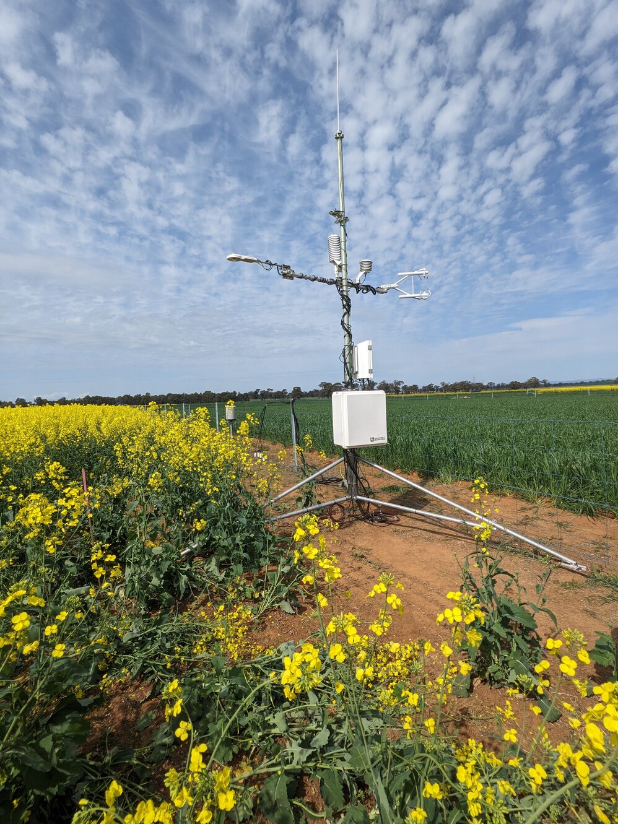
[picture p29: images/tower_types/Triod_tower_Dooke1_year1_PXL_20240911_030259457.jpg]
Tripod tower in agricultural environment (Dookie 1, first year of operation, Markus Loew)


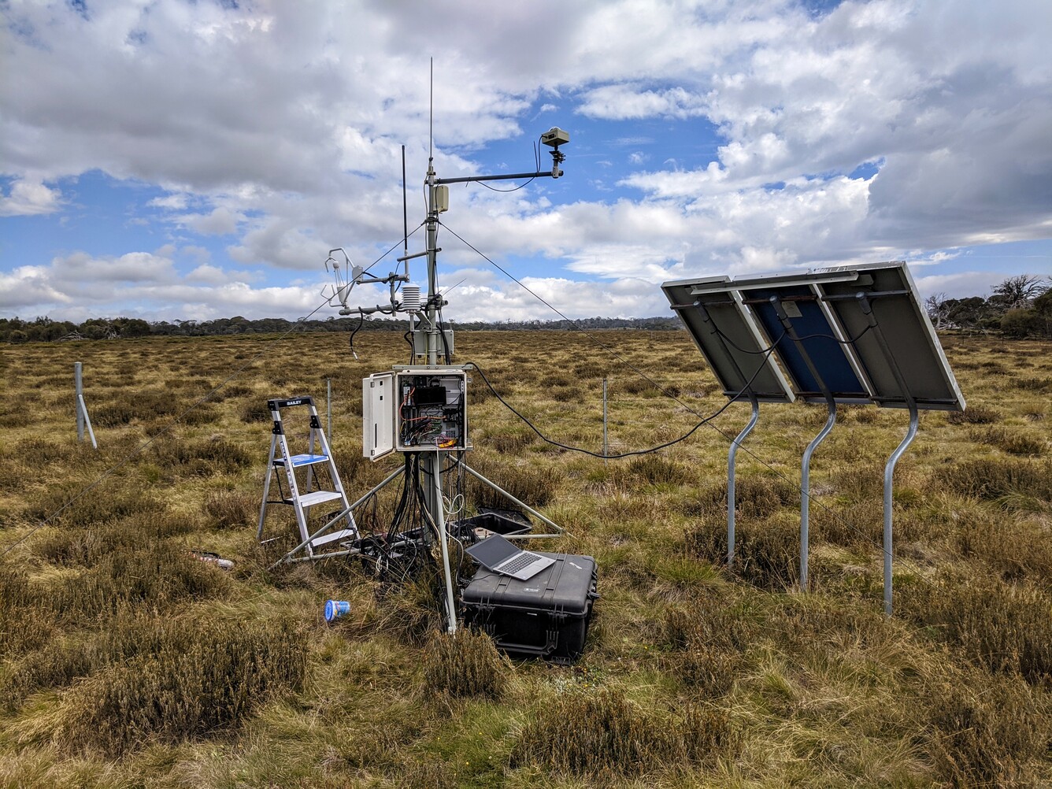
[picture p30: images/tower_types/Dargo_tripod_tower_IMG_20200224_120248.jpg]
Dargo tripod tower (Ian McHugh, photo Markus Loew)


For sites that are actively accruing canopy height, plan to construct the tower at least 5 (hc d), but mount the sensors at d C 4(hc d) at inception. The tower and measurement height shall be changed at a convenient time of the year when the height of the sensors (hm) is \< d C 3.6(hc d) (@aubinet_eddy_2012).

For crops with changing canopy heights that remain below 3 m, 8 m is the suggested measurement height” (@aubinet_eddy_2012).

## Lattice tower

-   [NBS Masts](https://nbsmasts.com.au/): Telescopic, hinged/tilt, lattice towers
-   [APAC Infrastructure mounting structures](https://apacinfrastructure.com.au/product-catalogue/mounting-structures)

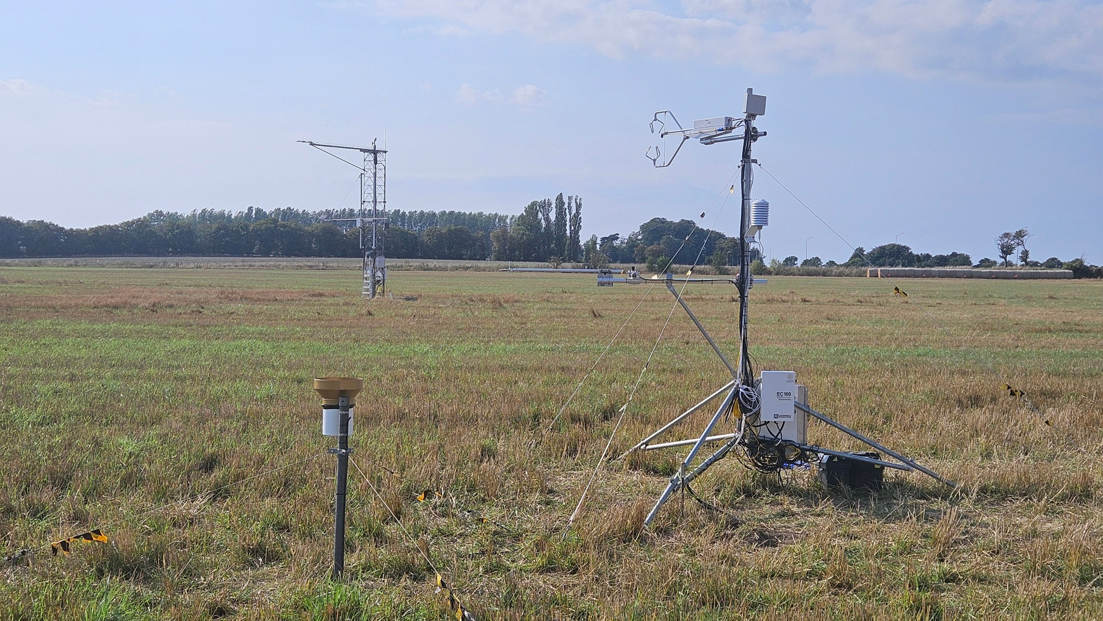
[picture p31: images/tower_types/Lund_towers_bafkreidpdzcmwtwzfppy2coa6zbdozl6vgo44rw43kwc2ltpeyi5tftq7e.jpg]
Lattice tower and tripod tower (Lund University Flux Measurement Group, [lufluxes.bsky.social/](https://bsky.app/profile/lufluxes.bsky.social/post/3m3d4yyv5nc2x)).


## Hinged towers

Various heights up to 14 m. These towers can be climbed (working at heights certificate required). But the hinged construction allows to lower the tower down for instrument installation and maintenance to avoid climbing.

Available from:

-   [APAC Portable Hinged Tripod Lattice Tower, AL340 Series](https://apacinfrastructure.com.au/al340-portable-tripod-lattice-tower-8-metre)\
    and\
    [APAC Hinged Winch Mast](https://apacinfrastructure.com.au/product-catalogue/mounting-structures/gh100-galvanised-steel-hinged-mast-winch-raised)\
    APAC Infrastructure Pty Ltd, Unit 6/33-47 Fred Chaplin Circuit, Caloundra, Sunshine Coast, QLD, 4551

-   [NBS Masts](https://nbsmasts.com.au/): Telescopic, hinged/tilt, lattice towers\
    NBS Masts, PO Box 7, Lindenow, Victoria, Australia, 3865, 03 5157 1203, sales\@nbsmasts.com.au

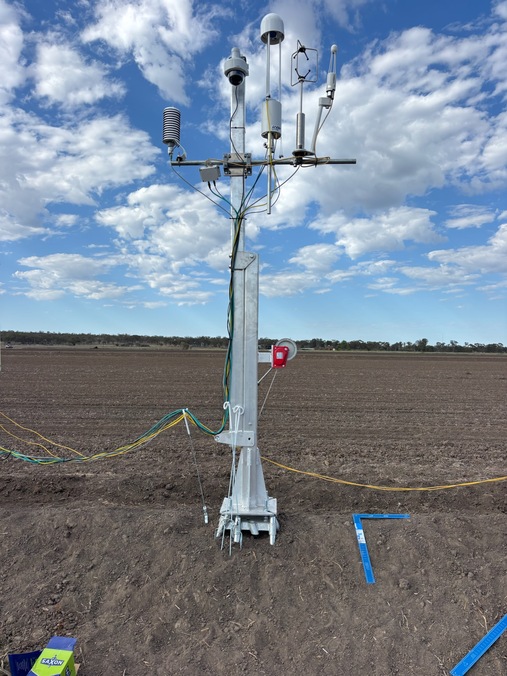
[picture p32: images/tower_types/Hinged_tower_IMG_20251128_125001.jpg]
APAC hinged winch mast with surefoot base (Liam Grace).


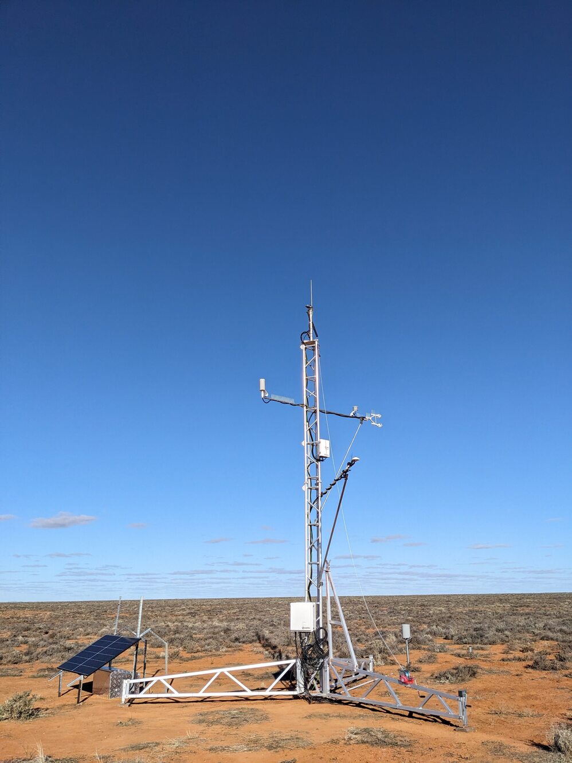
[picture p33: images/tower_types/Boolcoomatta_hinged_tower_PXL_20250813_061750715.jpg]
Boolcoomatta hinged tower on tripod base from APAC. (Markus Loew)


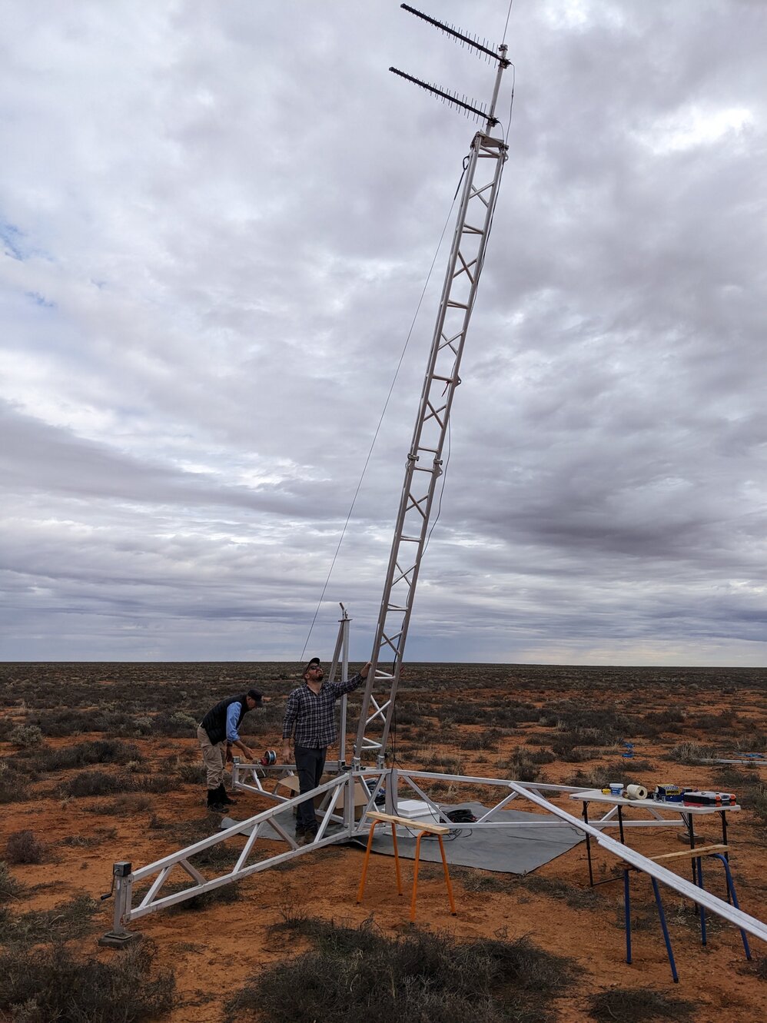
[picture p34: images/tower_types/Boolcoomatta_hinged_tower_PXL_20250812_010904174.MP.jpg]
Boolcoomatta hinged tower: hinge and alignment test. (Markus Loew)


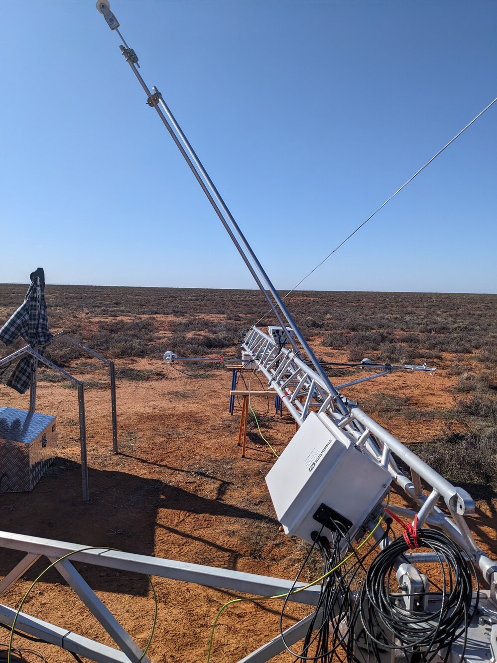
[picture p35: images/tower_types/Boolcoomatta_hinged_tower_PXL_20250813_002338525.jpg]
Boolcoomatta hinged tower during sensor and equipment install on the ground. No climbing required (Markus Loew).


### Foundations for small and/or hinged towers

These small or hinged towers do not require an extensive foundation in the ground. Two options of installing the APAC towers exist:

-   Tripod: leave-no-trace, convenient, not as stable as surefoot base (see photos above).
-   Surefoot base: very solid, but requires steel rods to be driven into the ground with a jackhammer at various directions. A petrol-powered jackhammer with anvil attachement is required. See the Surefoot jackhammer suggestions and requirements in the [Surefootings manual](https://surefootfootings.com.au/wp-content/uploads/2022/08/Surefoot_B-Low-Resolution-1.pdf). These rods can not be removed when the flux tower reaches its end-of-life or end of project and is taken down. Rocky locations might hinder the installation of the ground rods.\
    See [APAC surefoot modules](https://apacinfrastructure.com.au/search?keywords=products%20modules%20components), and [Surefoot base](https://surefootfootings.com.au/surefoot-pile-cap-s600-16p/) plate websites.

## Telescopic towers

E.g. pneumatic towers:

-   [EVTA Group Light telescopic towers](https://evtagroup.com.au/2-uncategorised/117-telescopic-light-tower)\
    EVTA Group, Gisborne, 12 Meek Street, New Gisborne, Victoria, 3438

-   [NBS Masts - Telescopic-mast](https://nbsmasts.com.au/product-category/telescopic-mast/)\
    NBS Masts, PO Box 7, Lindenow, Victoria, Australia, 3865

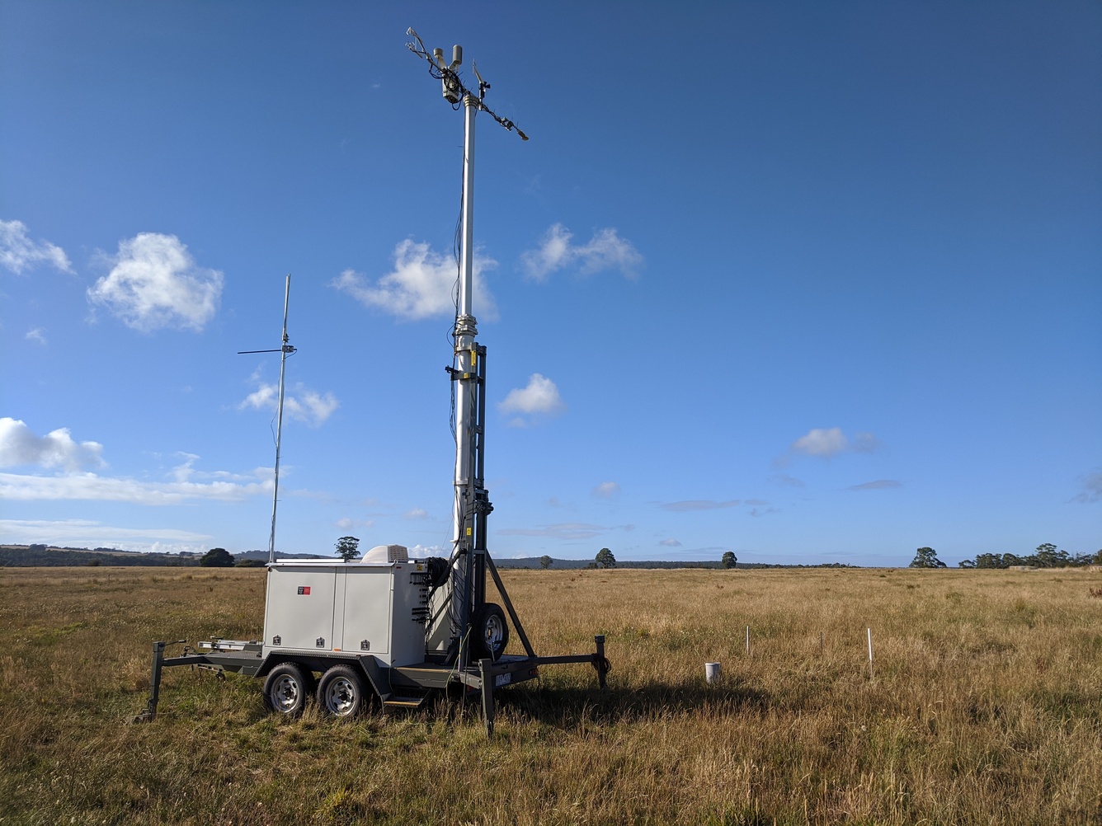
[picture p36: images/tower_types/telescopic_hinged_tower_IMG_20210223_090158.jpg]
Pneumatically operated telescopic, hinged tower on trailer platform using telescopic pole from EVTA (Swinburne University mobile flux towers, Markus Loew)


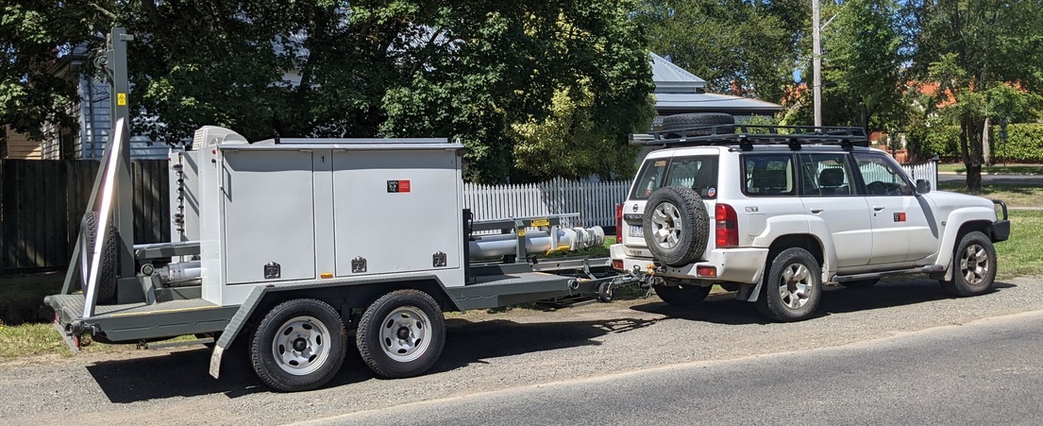
[picture p37: images/tower_types/telescopic_hinged_tower_PXL_20220311_031446953.MP.jpg]
Stowed-away pneumatic, telescopic, hinged tower (Swinburne University mobile flux towers, Markus Loew)


## Scaffolding towers

Not recommended in Australia!

OHS regulations require tower safety inspection every 30 days! But scaffolding towers are commonly used in Europe (Americas?) with and without guy wires. Benefit: scaffolding towers are cheap to build, and can be built on location without bringing in large cranes. This allows to minimise disturbance of the ecosystem during the build phase. The scaffolding can be buit in close vicinity of trees / branches which potentially allows to undertake leaf-level measurements and sampling in the canopy. The small size and lack of disturbance minimises the updraft, "chimney" effect that surround tall towers. Scaffolding towers can even have internal staircases or short ladders that make working at height easy. Regarding the relationship between tower size and average tree canopy horizontal size, scaffolding towers are clear winners due to their relatively small infrastructure footprint.

CNRA Redwood Forest Observatory scaffolding tower (from [CNRA Redwood Forest Observatory](https://wildfiretaskforce.org/cnra-and-partners-install-first-ever-redwood-forest-observatory/))

ICOS RF-FBn Font-Blanche tower <https://meta.icos-cp.eu/resources/stations/ES_FR-FBn>

## Guyed towers

Small footprint, but usually require crane to install, hence more initial disturbance to the environment. Guywires allow for slim and tall tower structures. However, the guy wires can bring the tower down when a tree falls on them (see Warra and Wombat Forest incidents).

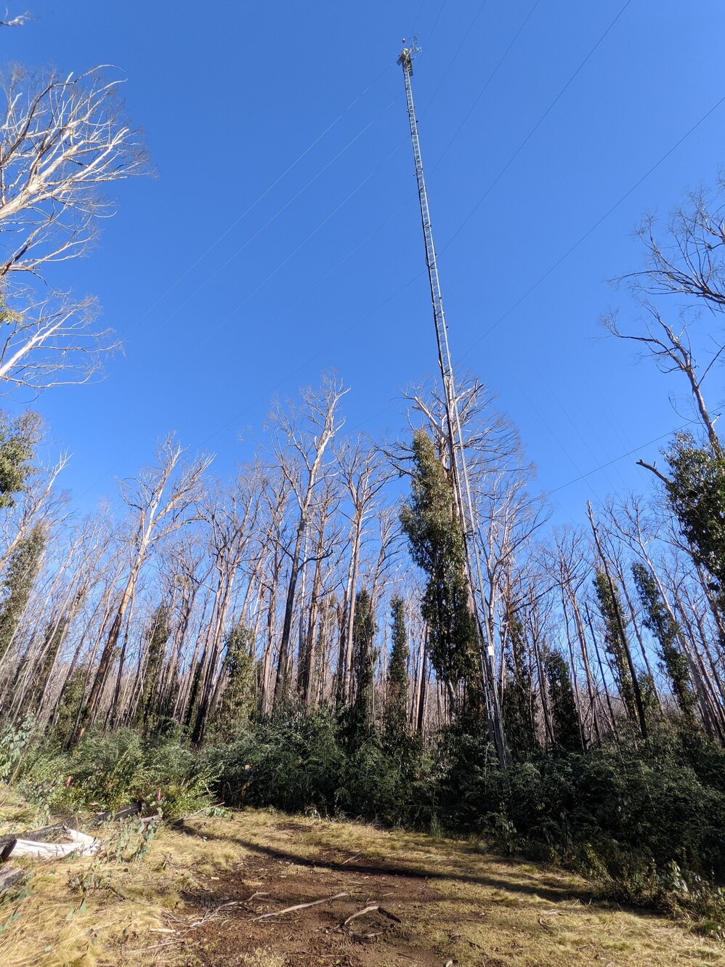
[picture p38: images/tower_types/Tumbarumba_pre-2025_guyed_tower_PXL_20220707_004347948.jpg]
Tumbarumba guyed tower (post fire, pre-2025) (Markus Loew).


## Stand-alone towers

Stand-alone towers provide a safe and stable work platform without the danger of trees falling on a guy wire taking the tower down in the process. They requires considerable amount of construction work, that will affect the vicinity of the tower. Large and deep excavations for the foundation are required, causing considerable disturbance of the immediate ecosystem. Cranes are needed to install the tower that bring soil compaction, disturbance and might require removal of trees to allow the crane to turn. Good road access to the tower is required as well to bring in excavators, concrete trucks, and cranes. Tall stand-alone towers can be big enough for a stair case. That allows easy access to the instrumentation on top. With a regulation-conform staircase on the tower, climbing certificates might not be required, similar to a public look-out tower (check your local laws and regulations).

The large physical footprint of stand-alone towers allows generous platforms on top. Such platforms make it easy to work at height compared to sitting in a harness suspended off the tower. However, in some cases, it can be difficult to install instrumentation along the height of the tall stand-alone towers where there is no platform and if the desired instrument location is far away from the staircase or ladder. Large. tall towers like e.g. Tumbarumba, have a wide lattice construction, limiting options for accessing some locations without extensive climbing. Tube dimensions of lattice and tower legs might require specific instrumentation mounts that are not available off-the-shelf. Check with your tower-construction company reagding instrumentation mounts when designing the tower. Off the shelf towers from e.g. ROAM are designed to suit heavy mobile phone systems which use 60 mm OD steel pipes and square/angle brackets to install instruments. These poles and brackets are not suitable out-of-the-box to install flux-related instruments as these are usually designed around round tubes with maximum 48 mm outer diameter.

Manufacturers, engineering companies of stand-alone towers and telecommunication infrastructure:

-   [Roam engineering](https://www.roameng.com.au/) Design, Manufacture and Construction of Steel Infrastructure\
    437 Victoria Road\
    Malaga, WA 6090 Australia\
    Phone [+61 892 484 950](tel:+61%20892%20484%20950)\
    [roam\@roameng.com.au](mailto:roam@roameng.com.au)\
    –\> Roam engineered the stand-alone Tumbarumba and Wombat Forest towers

-   [Clive Steele Partners](https://www.clivesteele.com.au/) Consulting Structural & Civic Engineers\
    62/195 Wellington Road\
    Clayton, VIC 3168 Australia\
    Phone: +61 3 9545 0223\
    csp\@clivesteele.com.au\
    –\> Clive Steele Partners engineered the 36 m stand-alone Whroo flux tower

-   [Amplitel](https://amplitel.com.au/) Tower infrastructure\
    Level 41, 242 Exhibition St\
    Melbourne, VIC 3000 Australia\
    Phone: 1800 267 548

-   [Everest infrastructure](https://everestinfrastructure.com.au/)\
    Suite 801, 203 Robina Town Centre Drive\
    Robina, QLD 4226 Australia\
    Phone +61 7 5551 4338\
    info\@everestinfrastructure.com.au

-   [Futureau Telecommunication engineering](https://www.futureau.com.au/)\
    7 Tamara Drive\
    Cockburn Central, WA 6164 Australia\
    Phone: +61 8 9417 4999\
    sales\@futureau.com.au

See [here for rigging companies that then build the tower at your location](./ClimbingRigging.html#riggers)

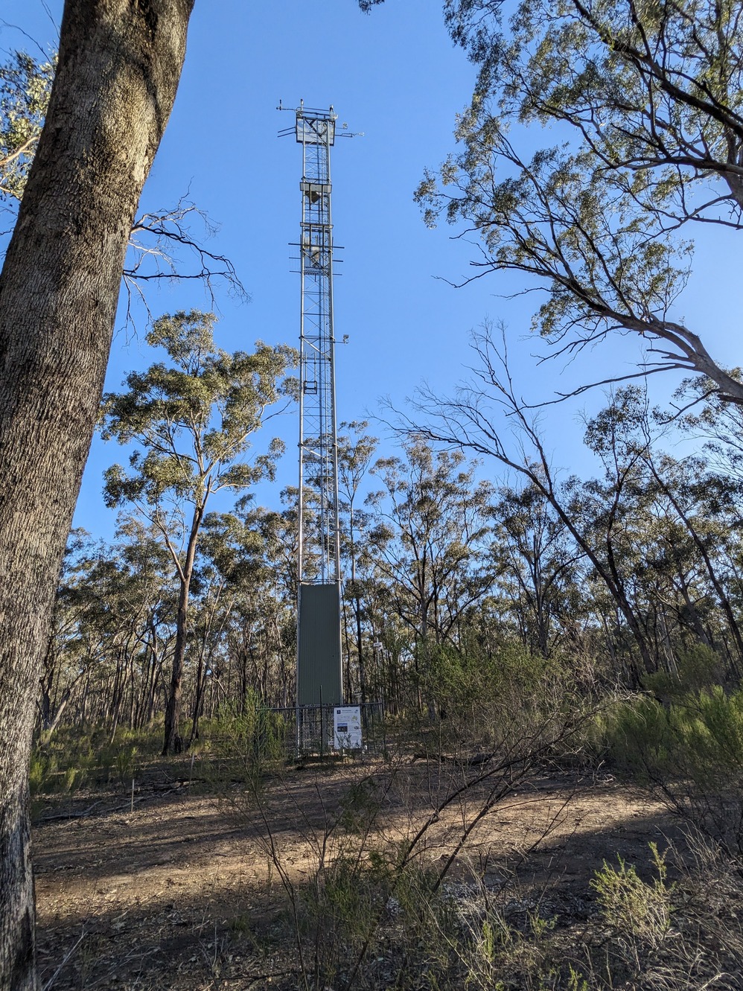
[picture p39: images/tower_types/Whroo_stand_alone_tower_PXL_20251119_072928938.jpg]
Whroo 36 m stand-alone tower with small footprint and ladder. Engineered by Clive Steele Partners, built by Commcons constructions. (Markus Loew)


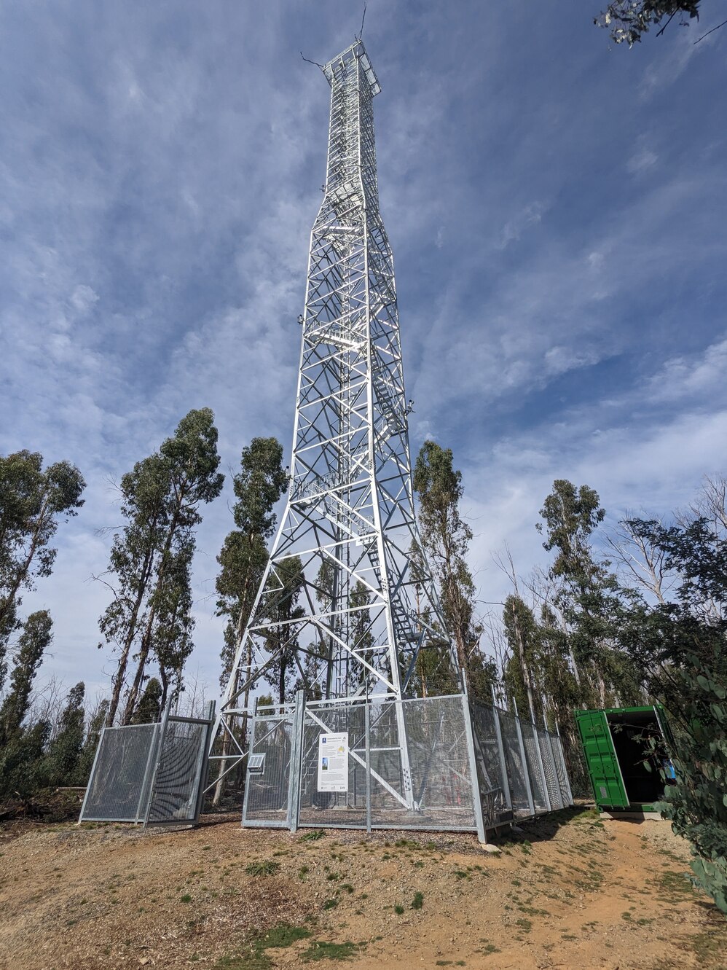
[picture p40: images/tower_types/Tumbarumba_post_2025_PXL_20250328_005142813.jpg]
Tumbarumba stand-alone 70 m tower (post 2025) with staircase. Engineered by Roam, built by Karera Pty. (Markus Loew)


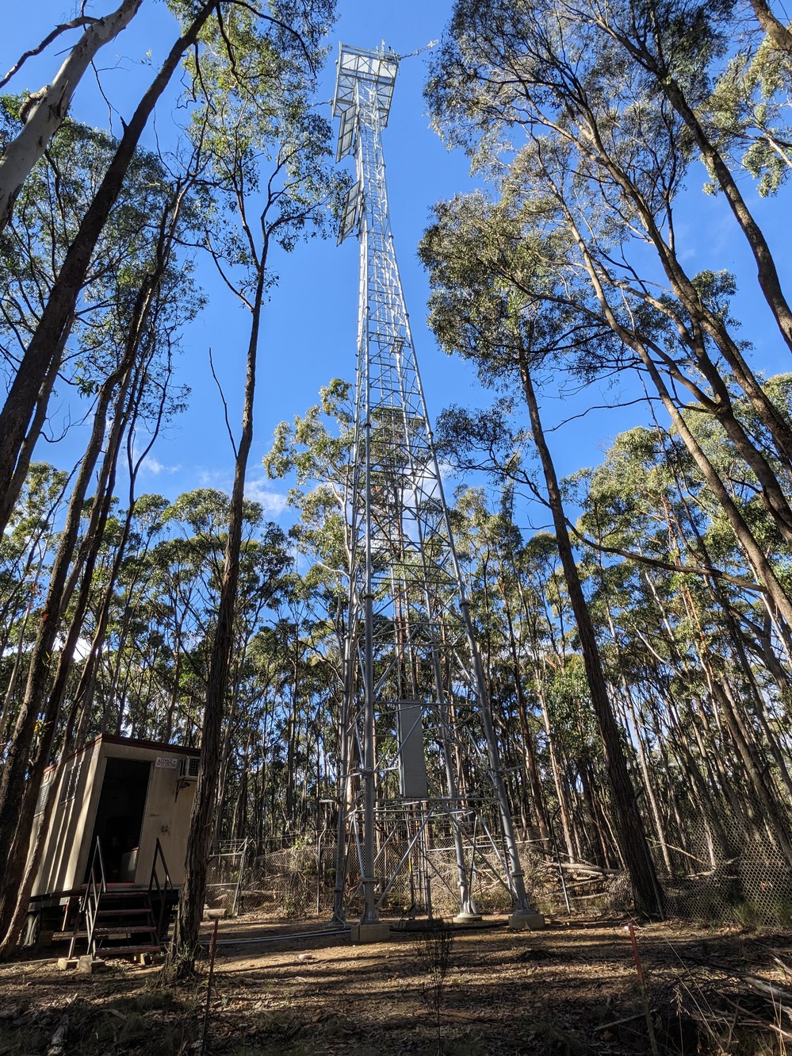
[picture p41: images/tower_types/WombatForest_stand_alone_tower_PXL_20240606_025120478.jpg]
Wombat Forest 40 m stand-alone tower with ladder. Designed and engineered by Roam, built by Meridian Communications. (Markus Loew)


[Home](./Home.html)
