MarkusLoew/OzFluxtowerhandbook/docs/images/communication/communication_serial_cables.jpg

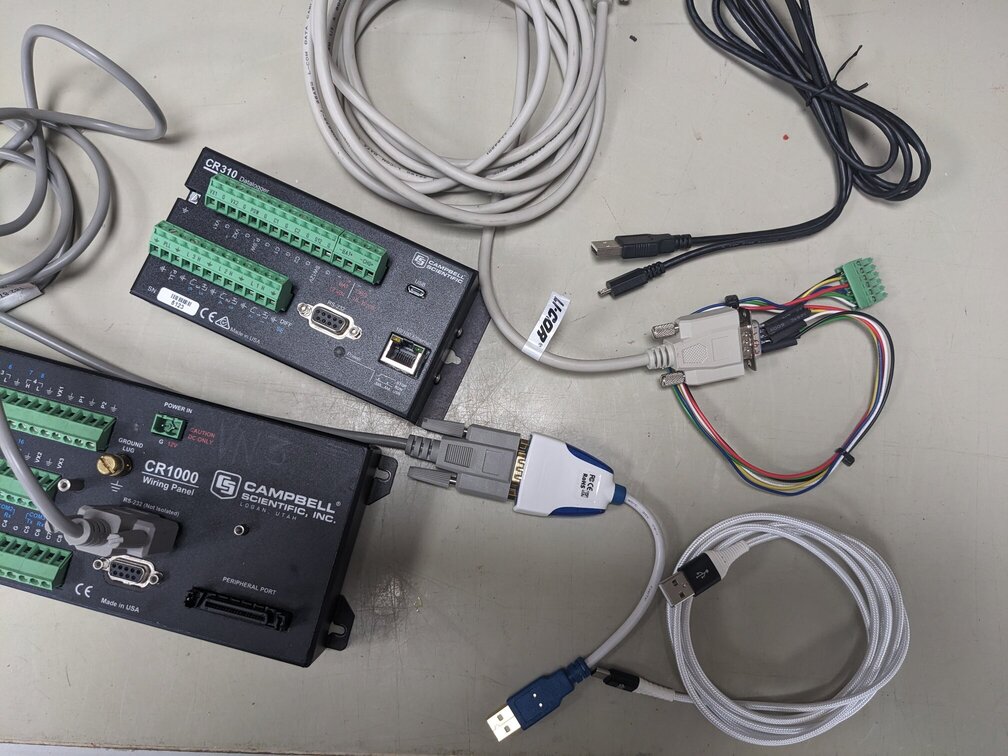
docs/images/communication/communication_serial_cables.jpg
