MarkusLoew/OzFluxtowerhandbook/docs/images/ovpn_images/CampbellScientific_Konect_Cell220.jpg

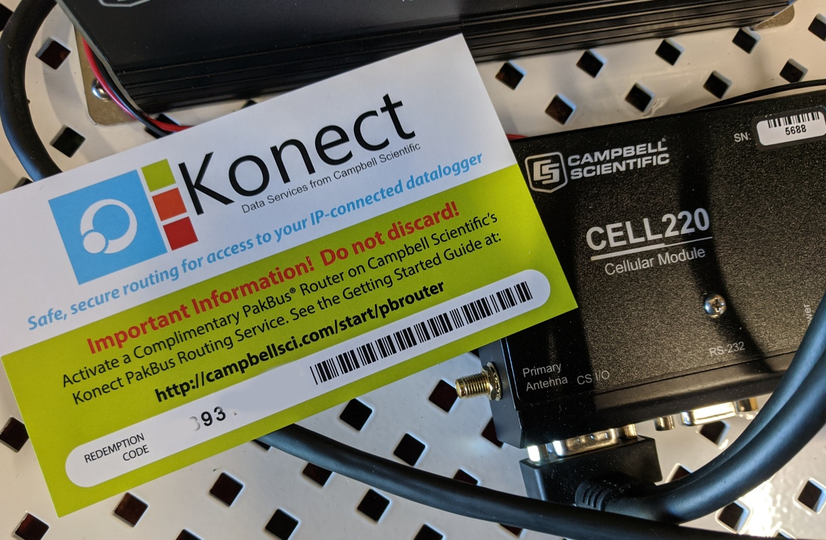
docs/images/ovpn_images/CampbellScientific_Konect_Cell220.jpg
