MarkusLoew/OzFluxtowerhandbook/docs/images/ovpn_images/Dualmax_modem_available_DynamicDNS_providers.png

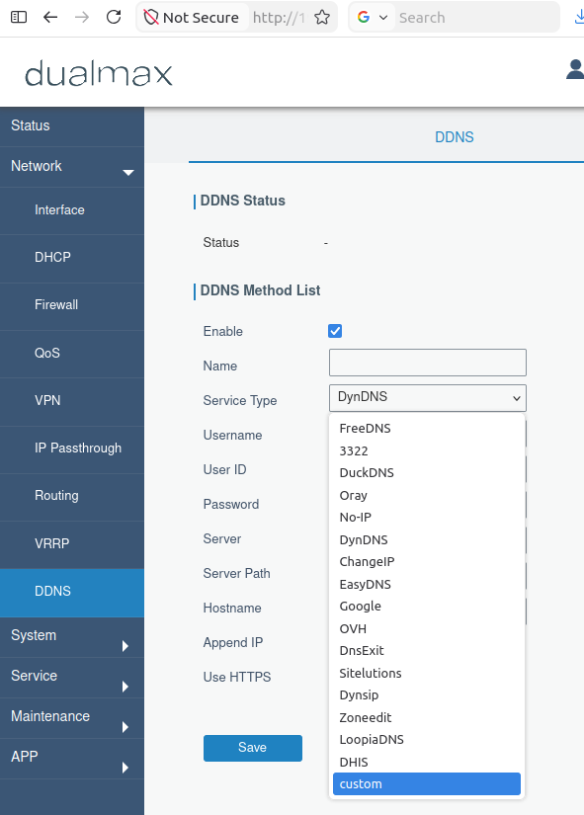
docs/images/ovpn_images/Dualmax_modem_available_DynamicDNS_providers.png
