MarkusLoew/OzFluxtowerhandbook/docs/images/ovpn_images/Dualmax_ovpn_config_individual_keys_OVPN_details.png

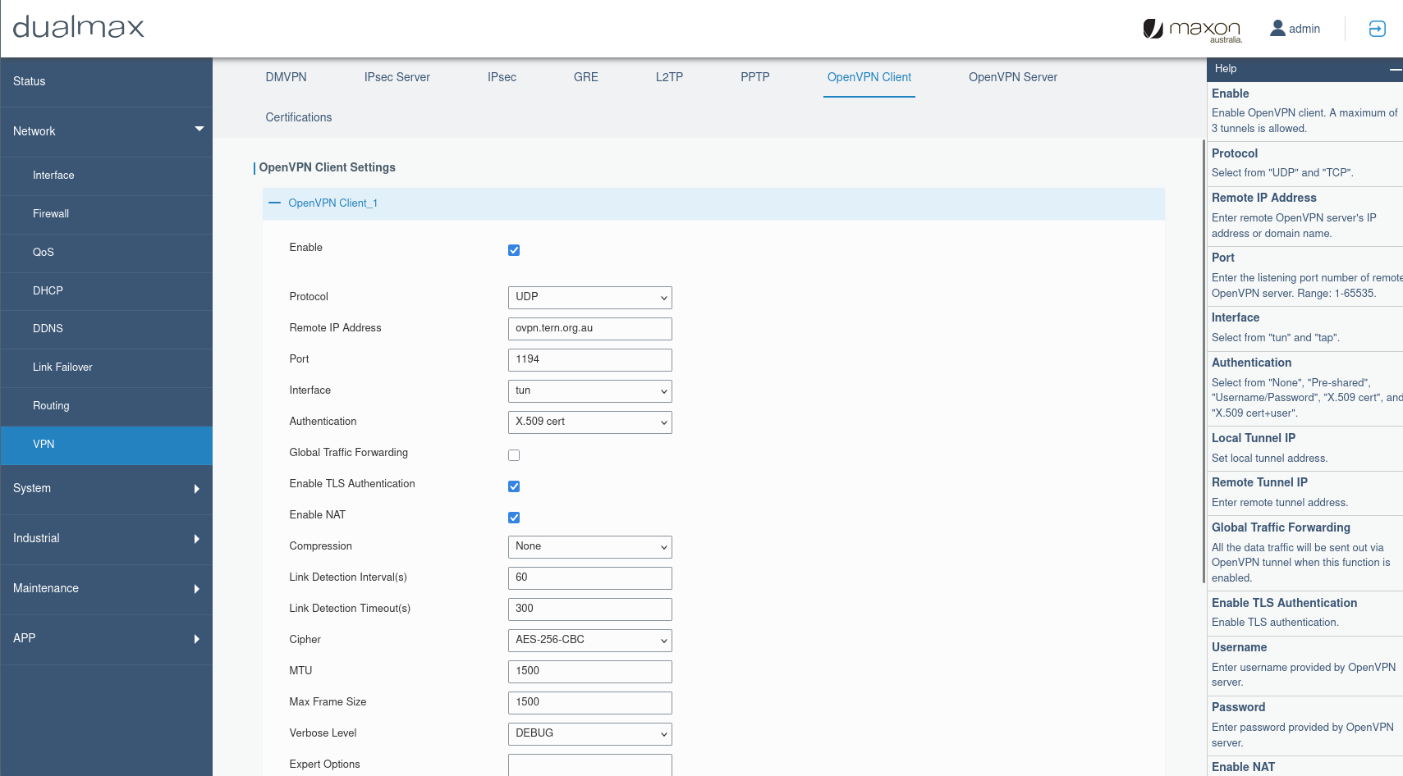
docs/images/ovpn_images/Dualmax_ovpn_config_individual_keys_OVPN_details.png
