MarkusLoew/OzFluxtowerhandbook/docs/images/ovpn_images/Dualmax_ovpn_config_individual_keys_ovpn_keys.png

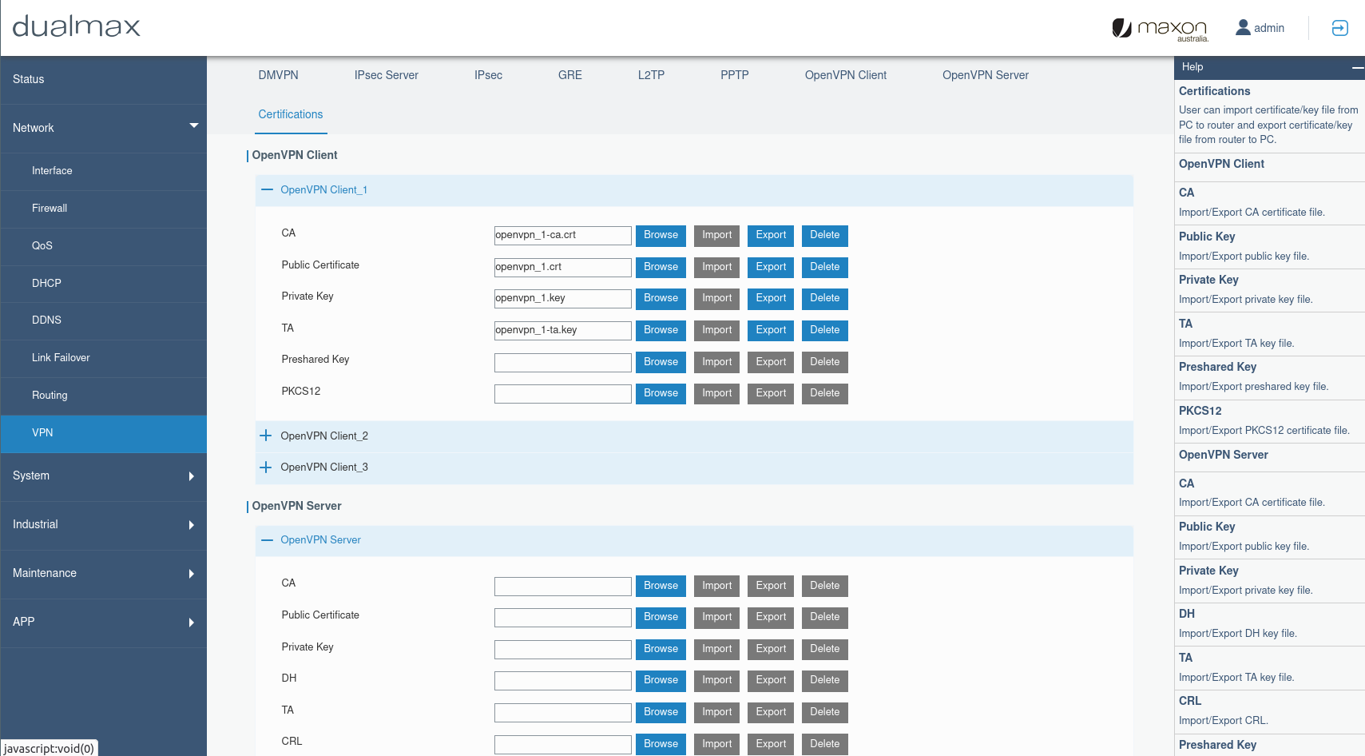
docs/images/ovpn_images/Dualmax_ovpn_config_individual_keys_ovpn_keys.png
