MarkusLoew/OzFluxtowerhandbook/docs/images/ovpn_images/Dualmax_ovpn_file_config.png

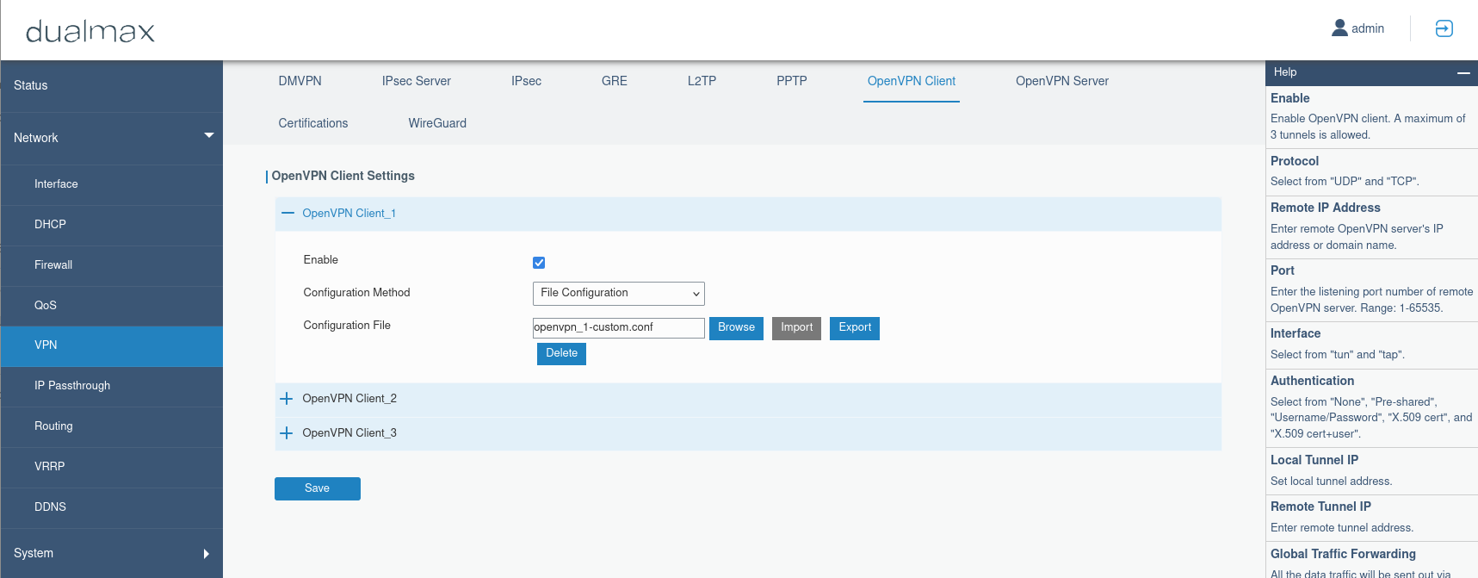
docs/images/ovpn_images/Dualmax_ovpn_file_config.png
