MarkusLoew/OzFluxtowerhandbook/docs/images/ovpn_images/Konect_Pakbus_Router_status.png

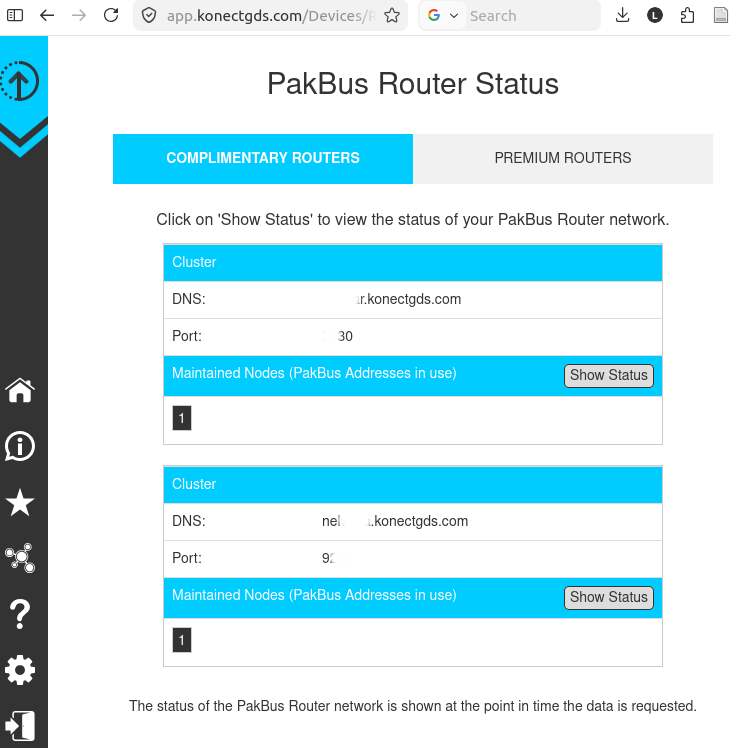
docs/images/ovpn_images/Konect_Pakbus_Router_status.png
