MarkusLoew/OzFluxtowerhandbook/docs/images/power/Battery_solar_power_system_double_battery_Whroo_tower.jpg

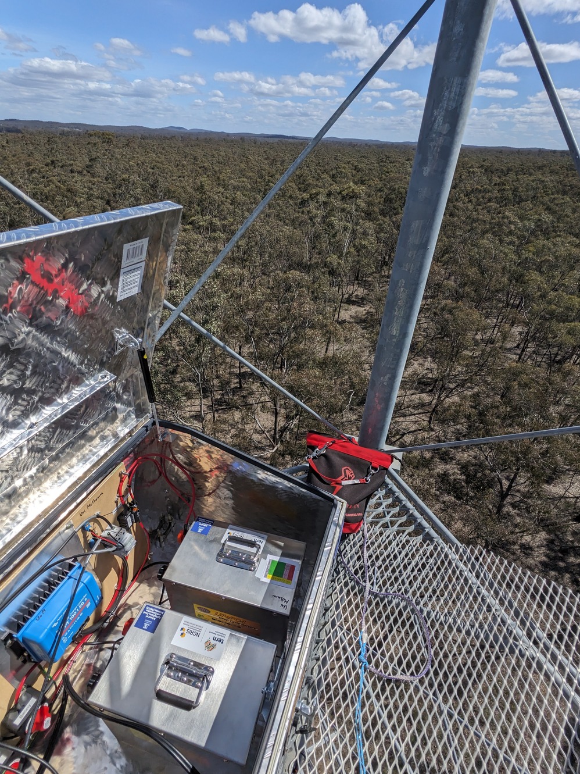
docs/images/power/Battery_solar_power_system_double_battery_Whroo_tower.jpg
