MarkusLoew/OzFluxtowerhandbook/docs/images/power/Solar_power_system.jpg

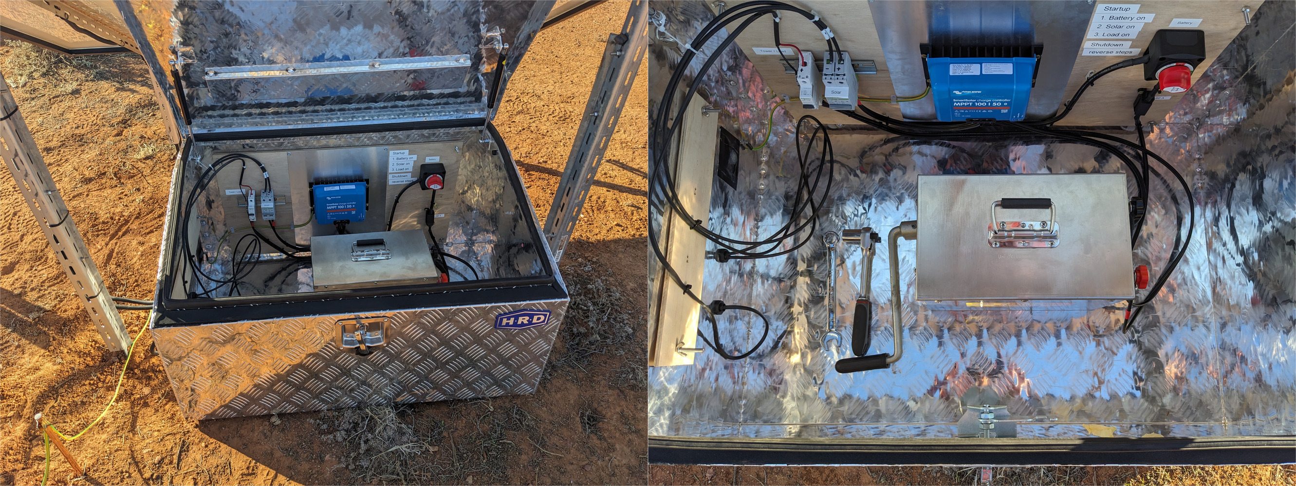
docs/images/power/Solar_power_system.jpg
