MarkusLoew/OzFluxtowerhandbook/docs/images/sensors/SDI12/SDI12_hub_terminal_blocks_DIY.jpg

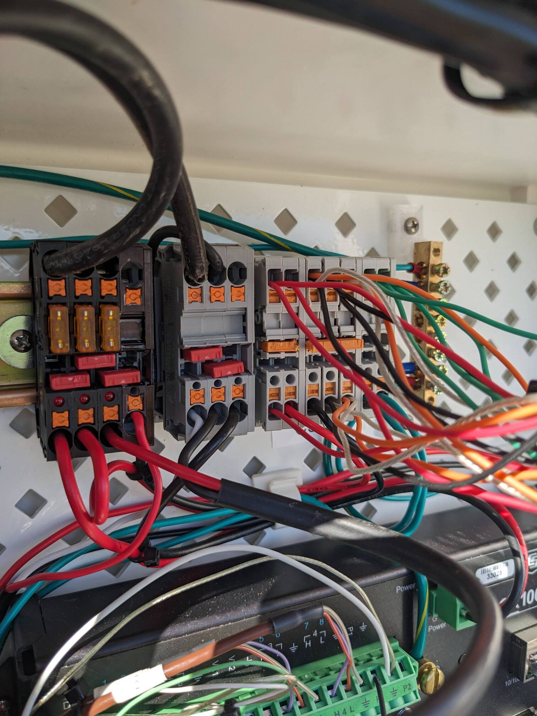
docs/images/sensors/SDI12/SDI12_hub_terminal_blocks_DIY.jpg
