MarkusLoew/OzFluxtowerhandbook/images/communication/Opensignal_Screenshot_20260410-093707.png

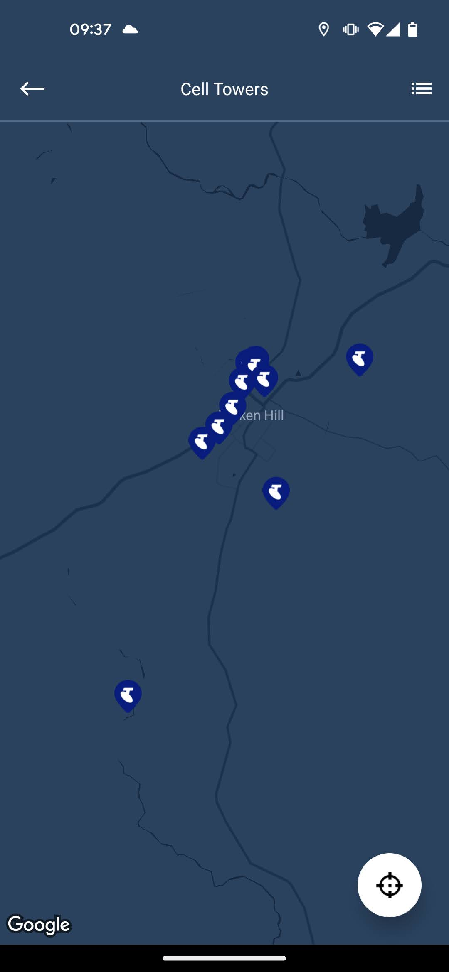
images/communication/Opensignal_Screenshot_20260410-093707.png
