MarkusLoew/OzFluxtowerhandbook/images/communication/out-0.jpg

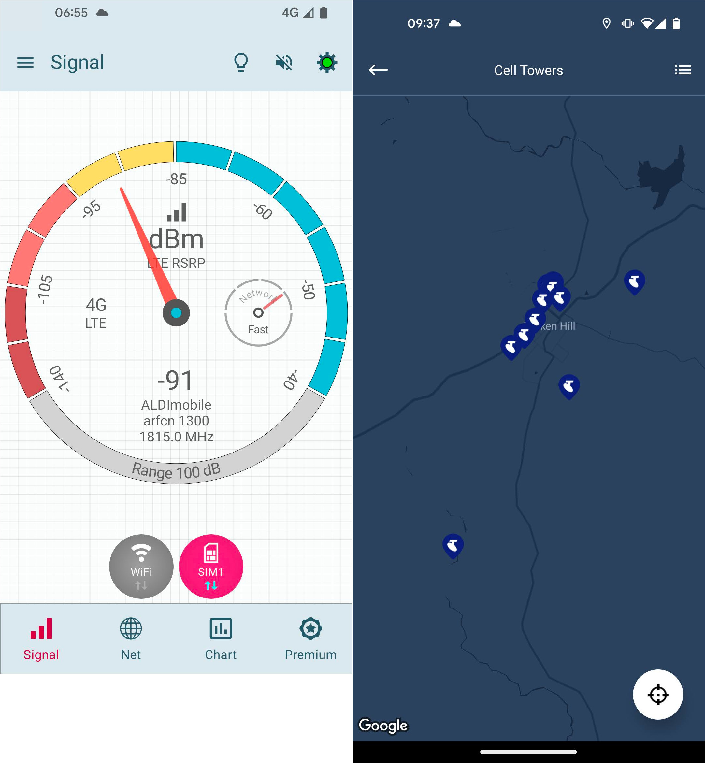
images/communication/out-0.jpg
