MarkusLoew/OzFluxtowerhandbook/images/communication/out-1.jpg

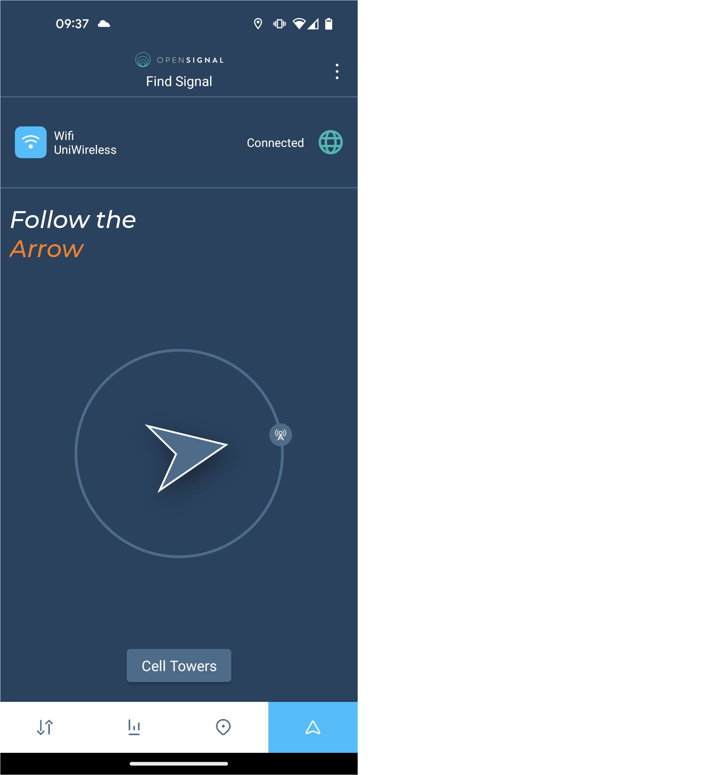
images/communication/out-1.jpg
