MarkusLoew/OzFluxtowerhandbook/images/communication/Robustel_modem_PXL_20260416_232923151.jpg

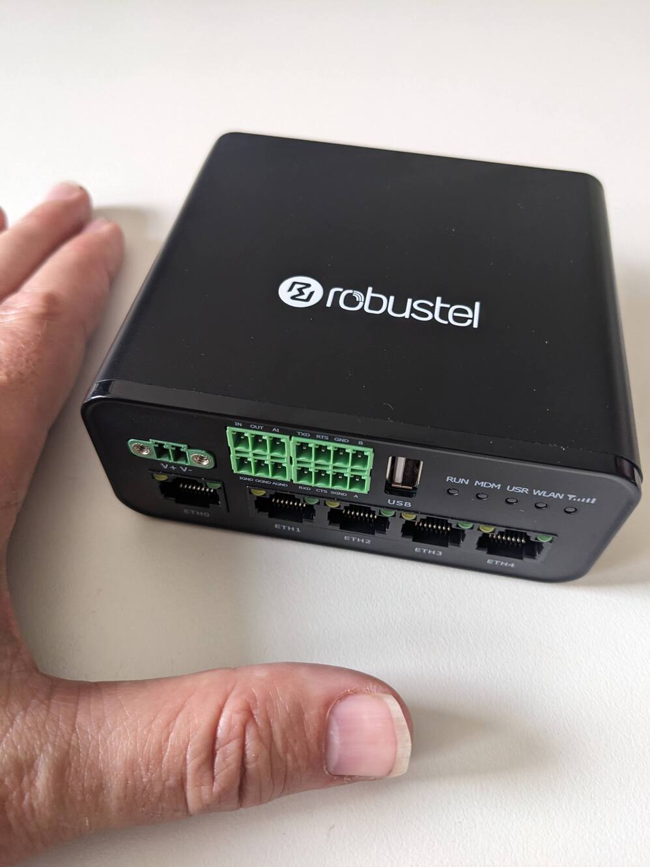
images/communication/Robustel_modem_PXL_20260416_232923151.jpg
