MarkusLoew/OzFluxtowerhandbook/images/communication/signal_strength_app_screenshot_20260410-065553.jpg

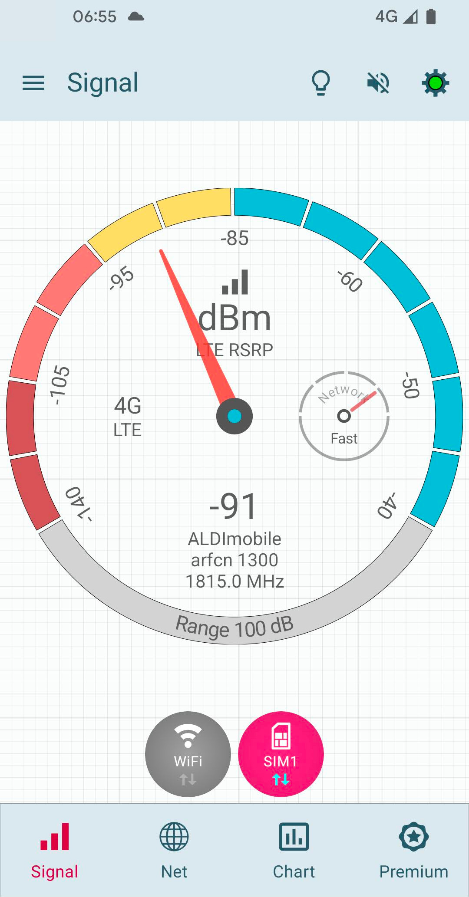
images/communication/signal_strength_app_screenshot_20260410-065553.jpg
