MarkusLoew/OzFluxtowerhandbook/images/enclosure/PXL_20261007_012430806.jpg

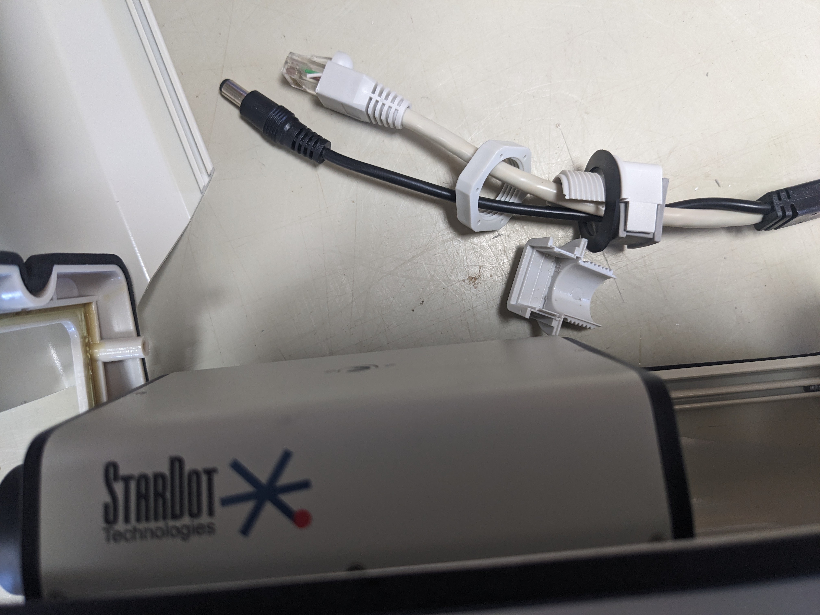
images/enclosure/PXL_20261007_012430806.jpg
