MarkusLoew/OzFluxtowerhandbook/images/enclosure/PXL_20261007_012830806.jpg

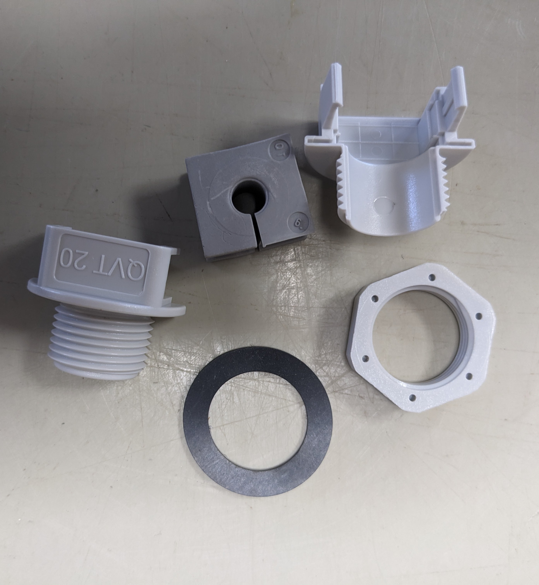
images/enclosure/PXL_20261007_012830806.jpg
