MarkusLoew/OzFluxtowerhandbook/images/phenocam/C9_exhaust_clamp_PXL_20260721_035954524.jpg

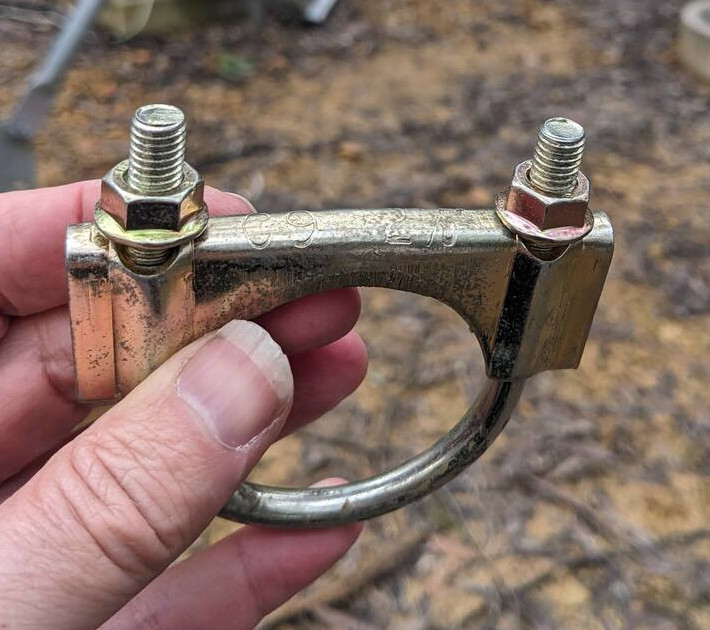
images/phenocam/C9_exhaust_clamp_PXL_20260721_035954524.jpg
