MarkusLoew/OzFluxtowerhandbook/images/phenocam/Stardot_netcamlive2_enclosure_PXL_20260721_040537669.jpg

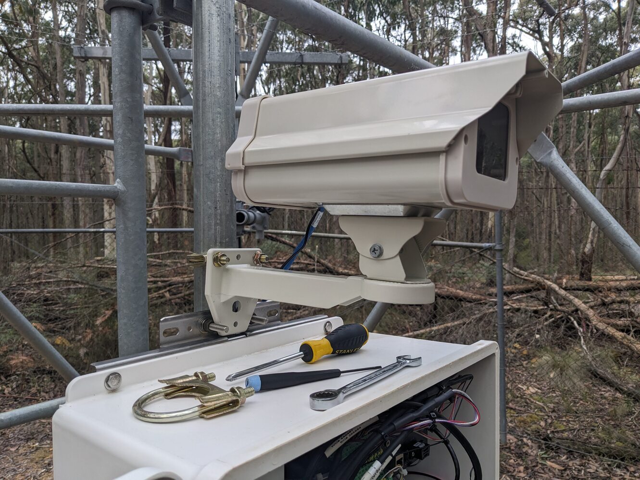
images/phenocam/Stardot_netcamlive2_enclosure_PXL_20260721_040537669.jpg
