MarkusLoew/OzFluxtowerhandbook/images/Tower_images/Dookie1_enclosure_PXL_20240809_045815456.jpg

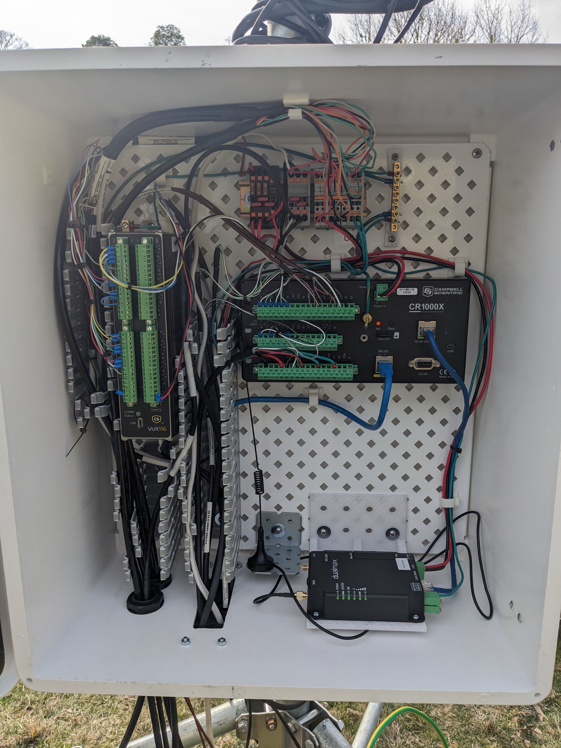
images/Tower_images/Dookie1_enclosure_PXL_20240809_045815456.jpg
