MarkusLoew/OzFluxtowerhandbook/images/Tower_images/Germany_Harz_Goettingen_bafkreihieys4cf7j5i6huafrttaulrq4caqkhszodlh4junhzl6ckzjoni.jpg

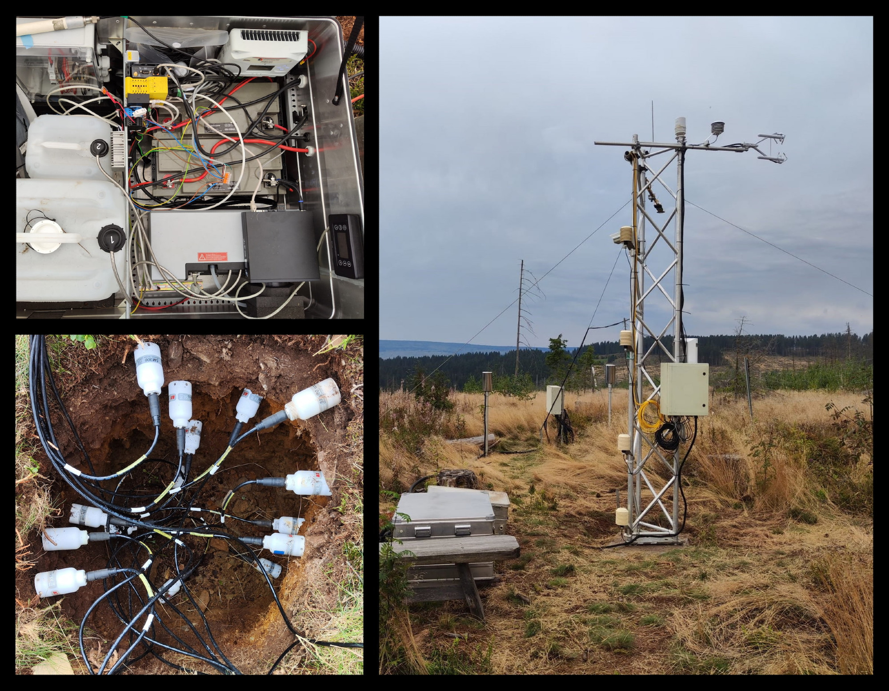
images/Tower_images/Germany_Harz_Goettingen_bafkreihieys4cf7j5i6huafrttaulrq4caqkhszodlh4junhzl6ckzjoni.jpg
