MarkusLoew/OzFluxtowerhandbook/images/Tower_images/Germany_lattice_tower_bafkreietpt2bkup6x6gsngzi2mtj32sxhb43gnmg4xbet65ucloioowqbu.jpg

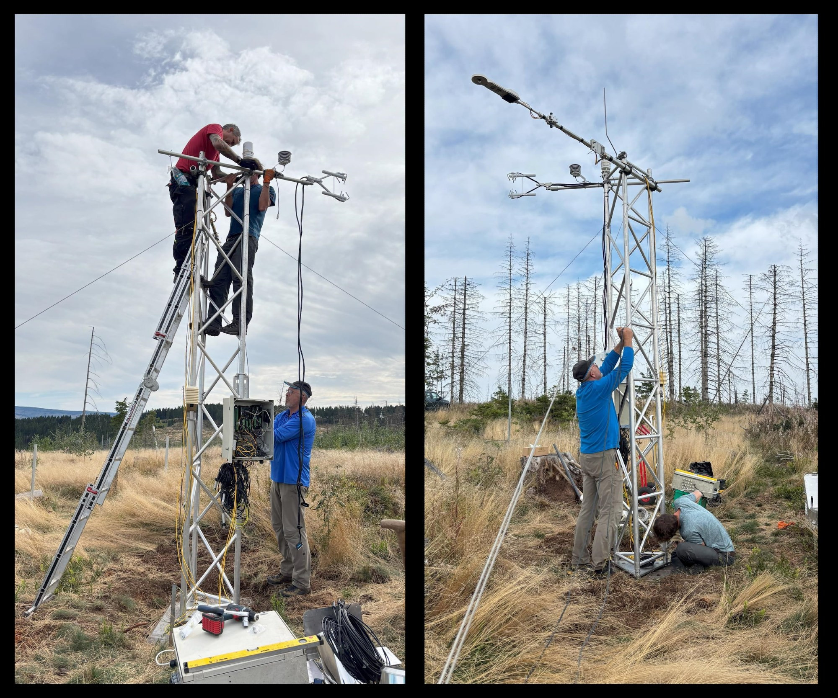
images/Tower_images/Germany_lattice_tower_bafkreietpt2bkup6x6gsngzi2mtj32sxhb43gnmg4xbet65ucloioowqbu.jpg
