MarkusLoew/OzFluxtowerhandbook/images/Tower_images/Heater_cable_enclosure_Tumba_PXL_20250312_053152582.jpg

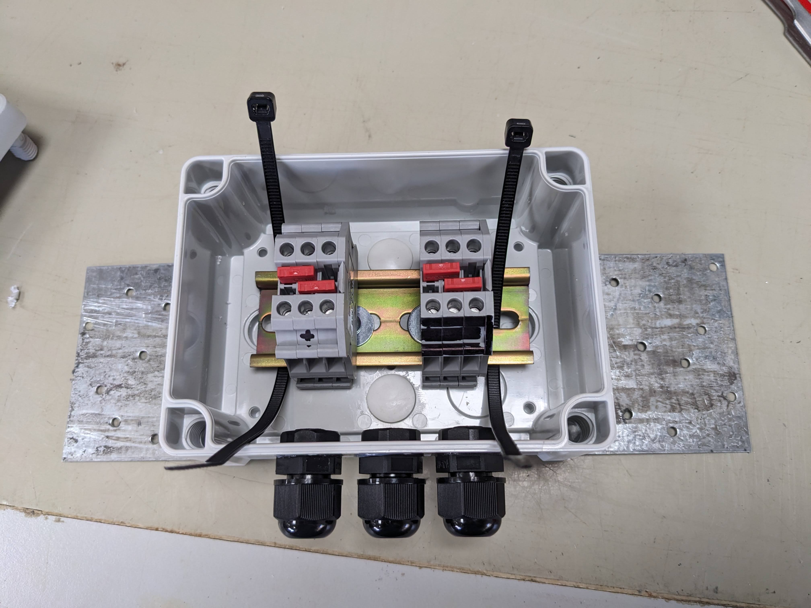
images/Tower_images/Heater_cable_enclosure_Tumba_PXL_20250312_053152582.jpg
