MarkusLoew/OzFluxtowerhandbook/images/Tower_images/Matt_enclosure_image003.jpg

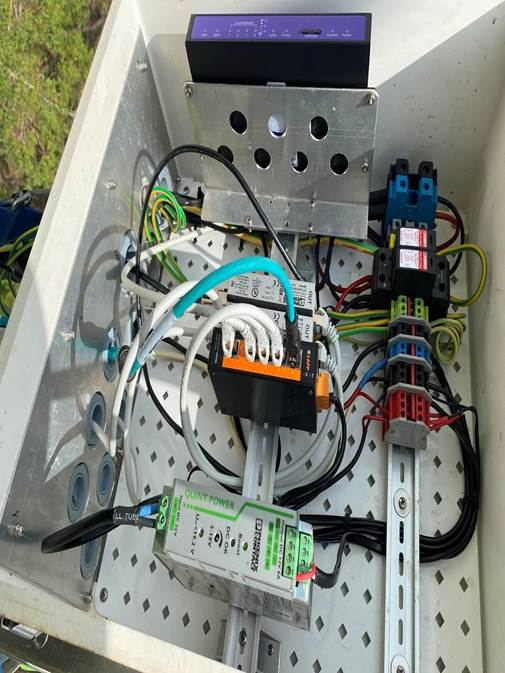
images/Tower_images/Matt_enclosure_image003.jpg
