MarkusLoew/OzFluxtowerhandbook/images/Tower_images/Matt_enclosure_image007.jpg

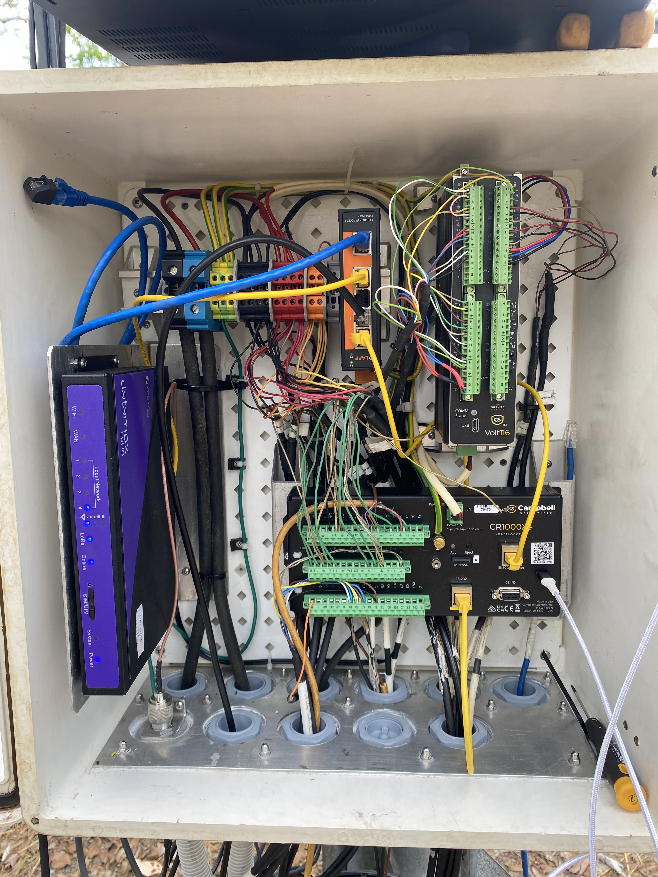
images/Tower_images/Matt_enclosure_image007.jpg
