MarkusLoew/OzFluxtowerhandbook/images/Tower_images/Tumbarumba_freestanding_walk_up_tower_PXL_20250205_233118943.jpg

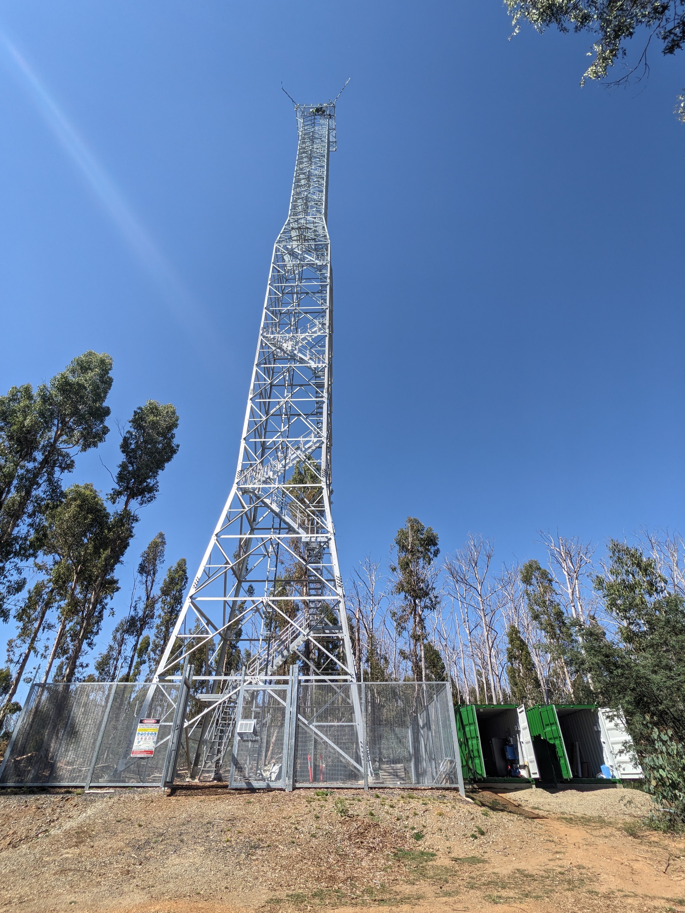
images/Tower_images/Tumbarumba_freestanding_walk_up_tower_PXL_20250205_233118943.jpg
