MarkusLoew/OzFluxtowerhandbook/images/Tower_images/Tumbarumba_power_and_modem_enclosure_PXL_20250206_212516490.jpg

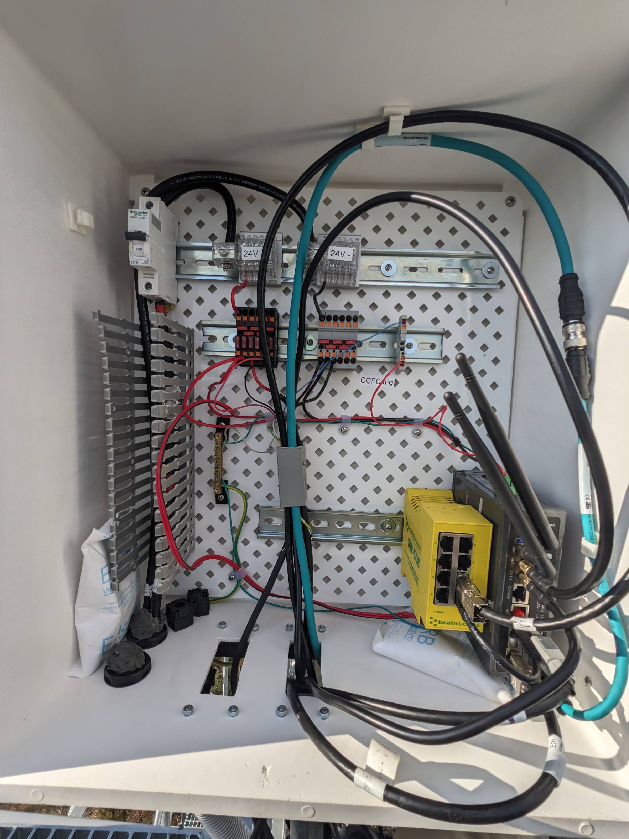
images/Tower_images/Tumbarumba_power_and_modem_enclosure_PXL_20250206_212516490.jpg
