MarkusLoew/OzFluxtowerhandbook/images/Tower_images/Wombat_Cable_bracket_PXL_20240522_014357222.jpg

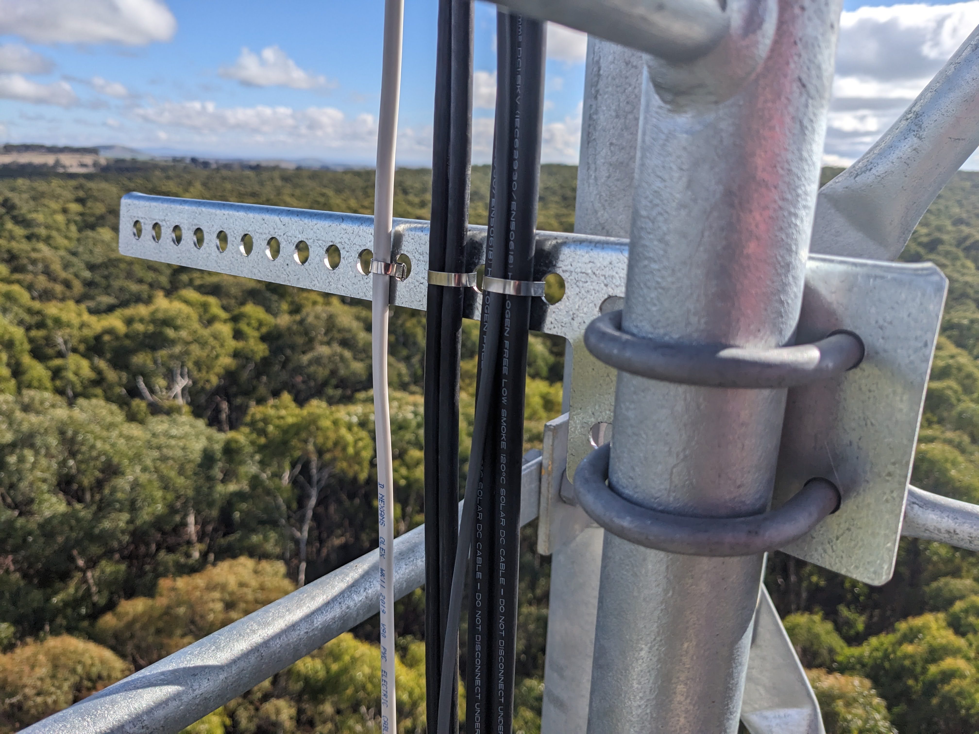
images/Tower_images/Wombat_Cable_bracket_PXL_20240522_014357222.jpg
