MarkusLoew/OzFluxtowerhandbook/images/Tower_images/Wombat_Cable_brackets_PXL_20251127_014006615.jpg

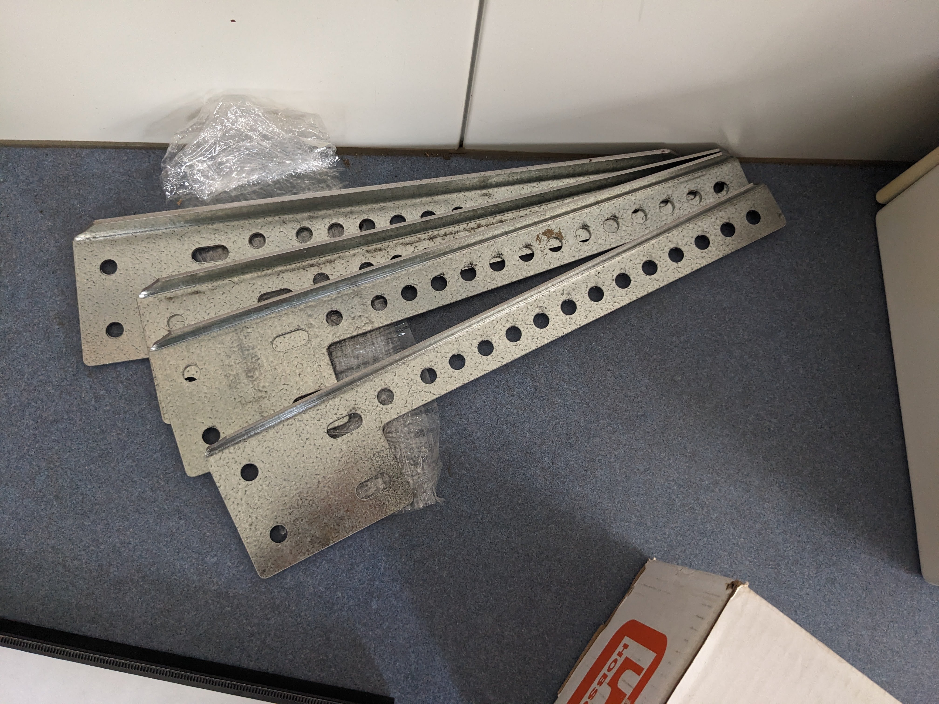
images/Tower_images/Wombat_Cable_brackets_PXL_20251127_014006615.jpg
