MarkusLoew/OzFluxtowerhandbook/images/tower_types/CNRA_Redwood_guyed_scaffold_tower_Flux-Tower-1536x864.jpg

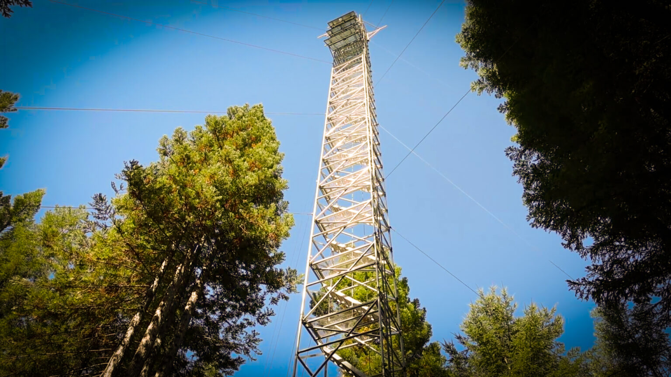
images/tower_types/CNRA_Redwood_guyed_scaffold_tower_Flux-Tower-1536x864.jpg
