MarkusLoew/OzFluxtowerhandbook/images/tower_types/telescopic_hinged_tower_IMG_20210420_081353.jpg

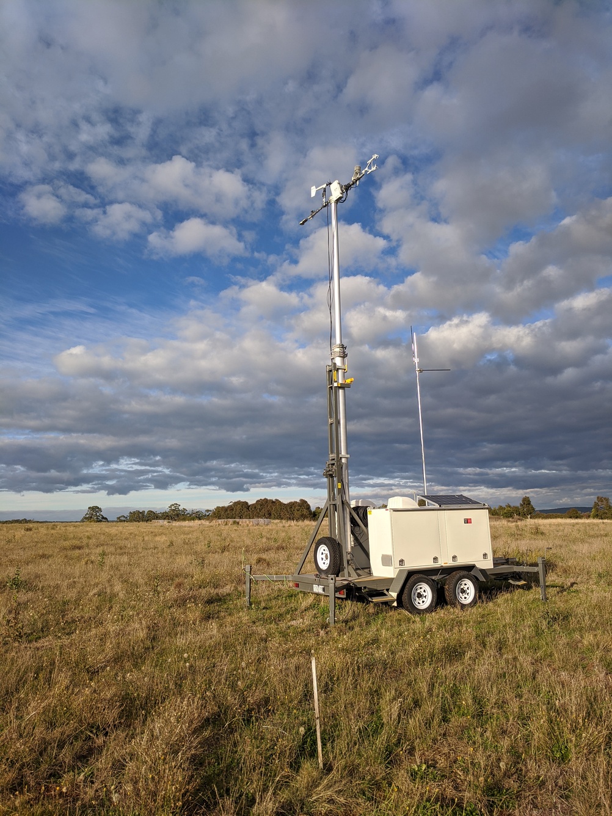
images/tower_types/telescopic_hinged_tower_IMG_20210420_081353.jpg
