MarkusLoew/OzFluxtowerhandbook/docs/downloads/Dualmax_modem_panel_mount_Loew.stl

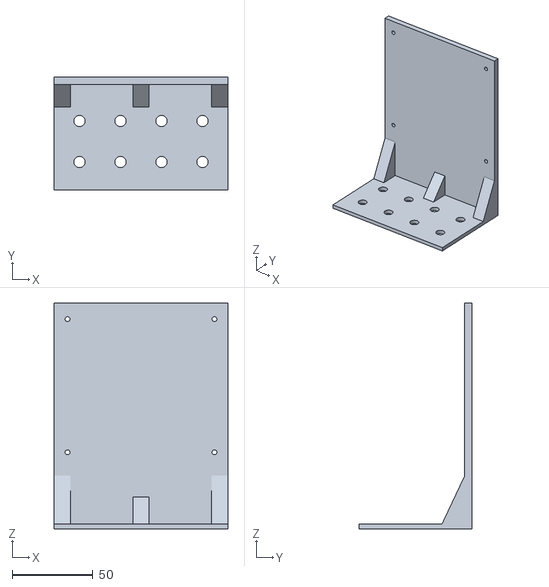
[picture p75: CAD file, 2026-04-09]
docs/downloads/Dualmax_modem_panel_mount_Loew.stl
107.5 x 70.0 x 140.0
