MarkusLoew/OzFluxtowerhandbook/docs/images/ovpn_images/Campbell_Scientific_Loggernet_Konect_setup.png

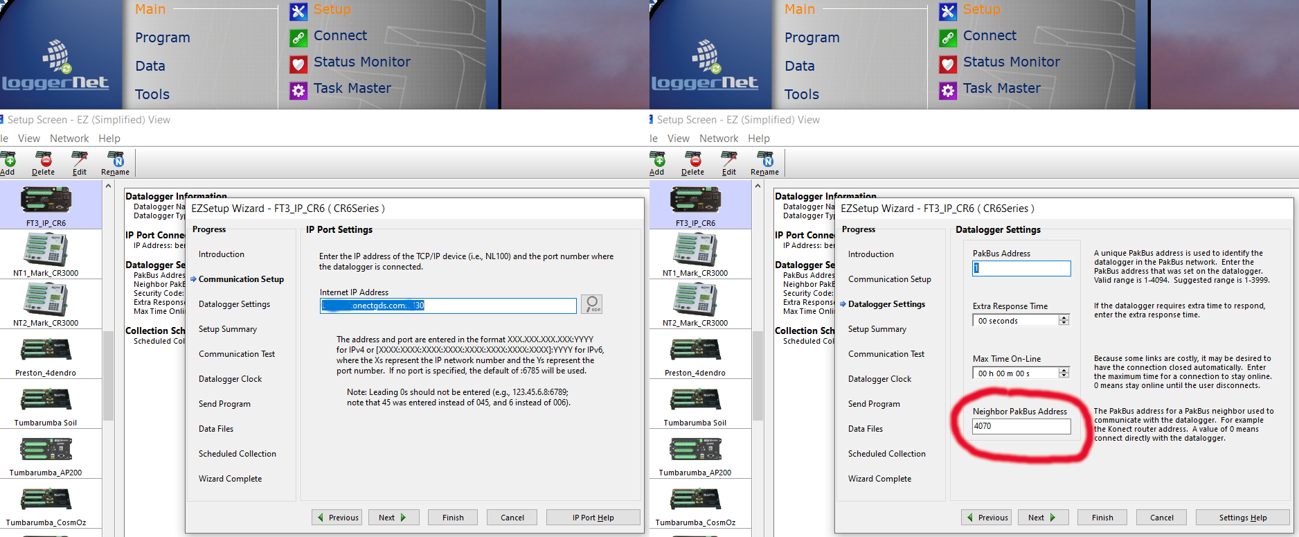
docs/images/ovpn_images/Campbell_Scientific_Loggernet_Konect_setup.png
