MarkusLoew/OzFluxtowerhandbook/docs/images/ovpn_images/ovpn_modem_setup_instructions_ML_html_5dcdc6e1.jpg

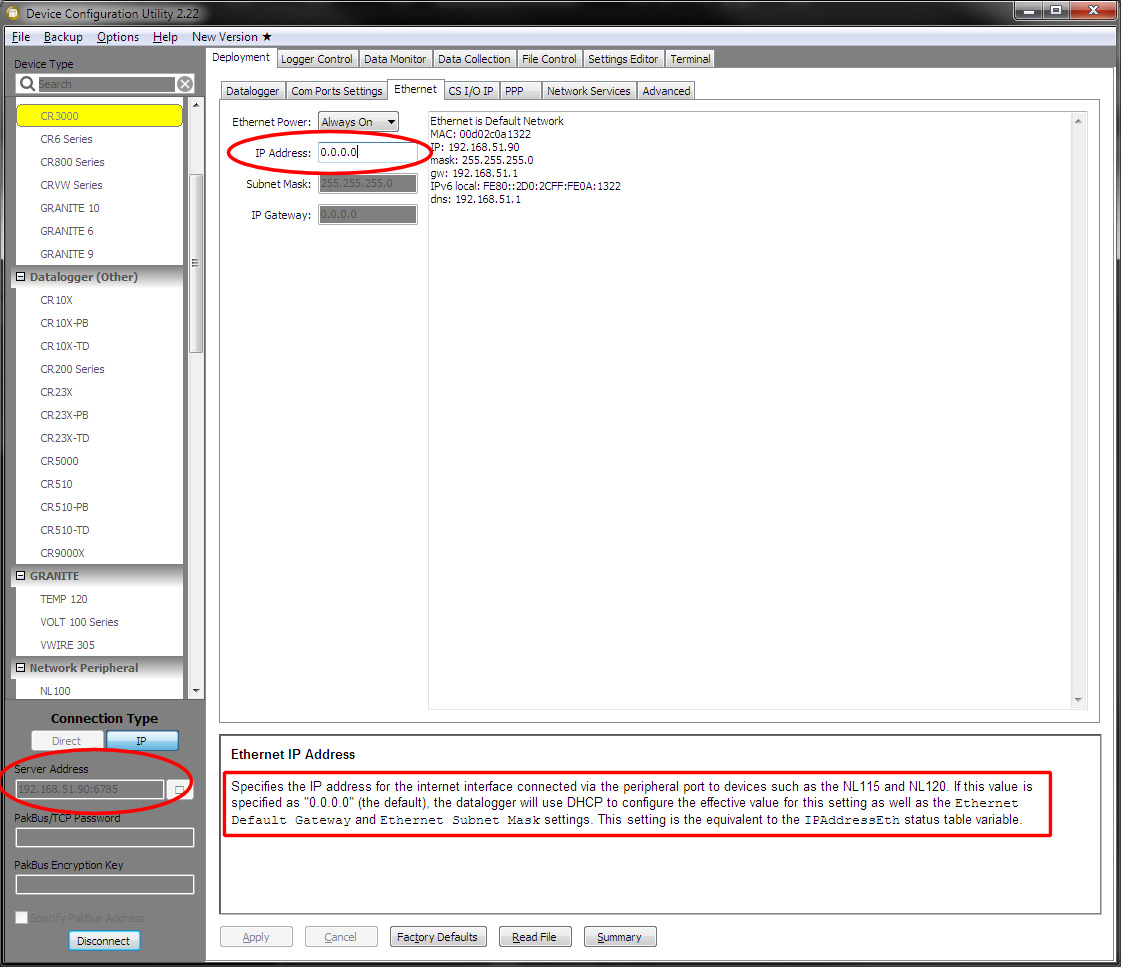
docs/images/ovpn_images/ovpn_modem_setup_instructions_ML_html_5dcdc6e1.jpg
