MarkusLoew/OzFluxtowerhandbook/docs/images/ovpn_images/ovpn_modem_setup_instructions_ML_html_7bcd34e0.png

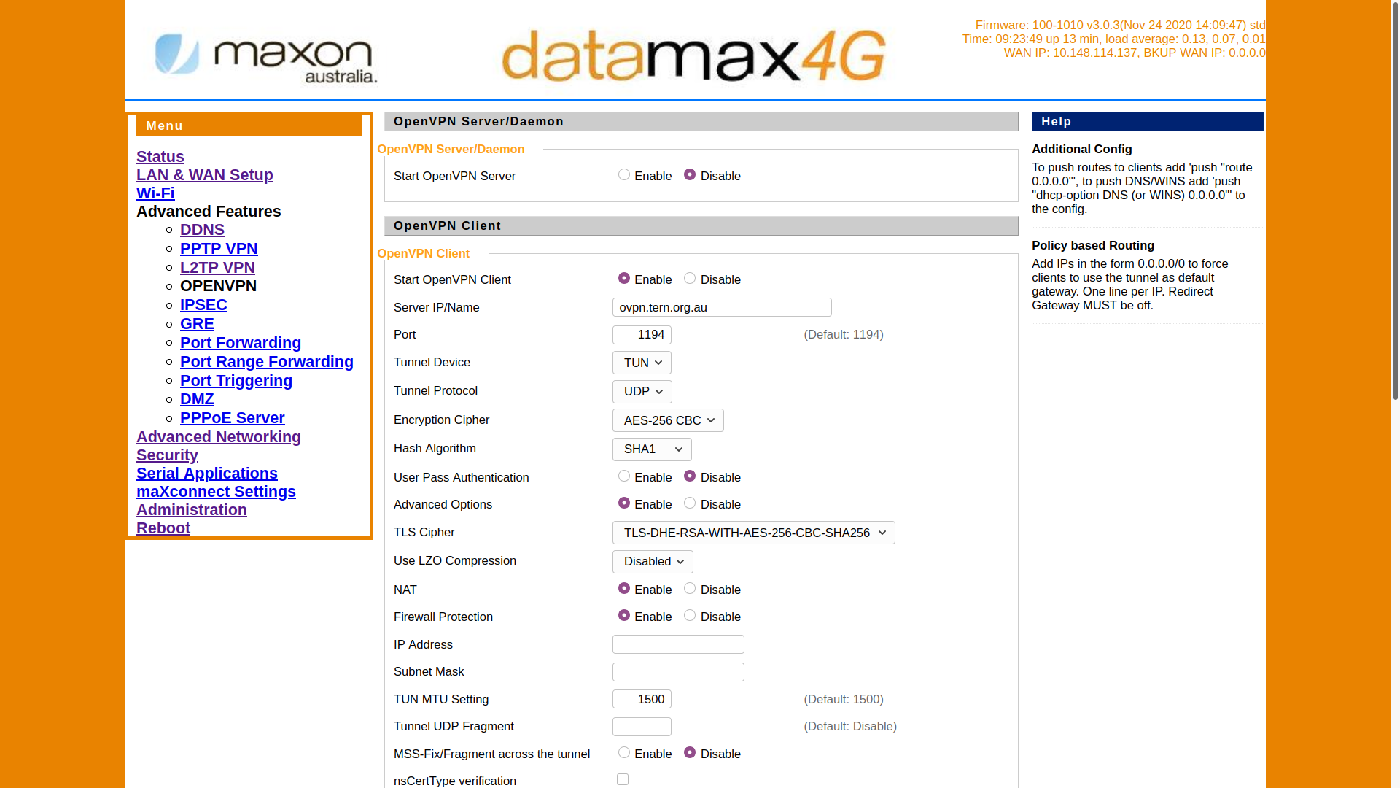
docs/images/ovpn_images/ovpn_modem_setup_instructions_ML_html_7bcd34e0.png
