MarkusLoew/OzFluxtowerhandbook/docs/images/ovpn_images/ovpn_modem_setup_instructions_ML_html_13c33a20.jpg

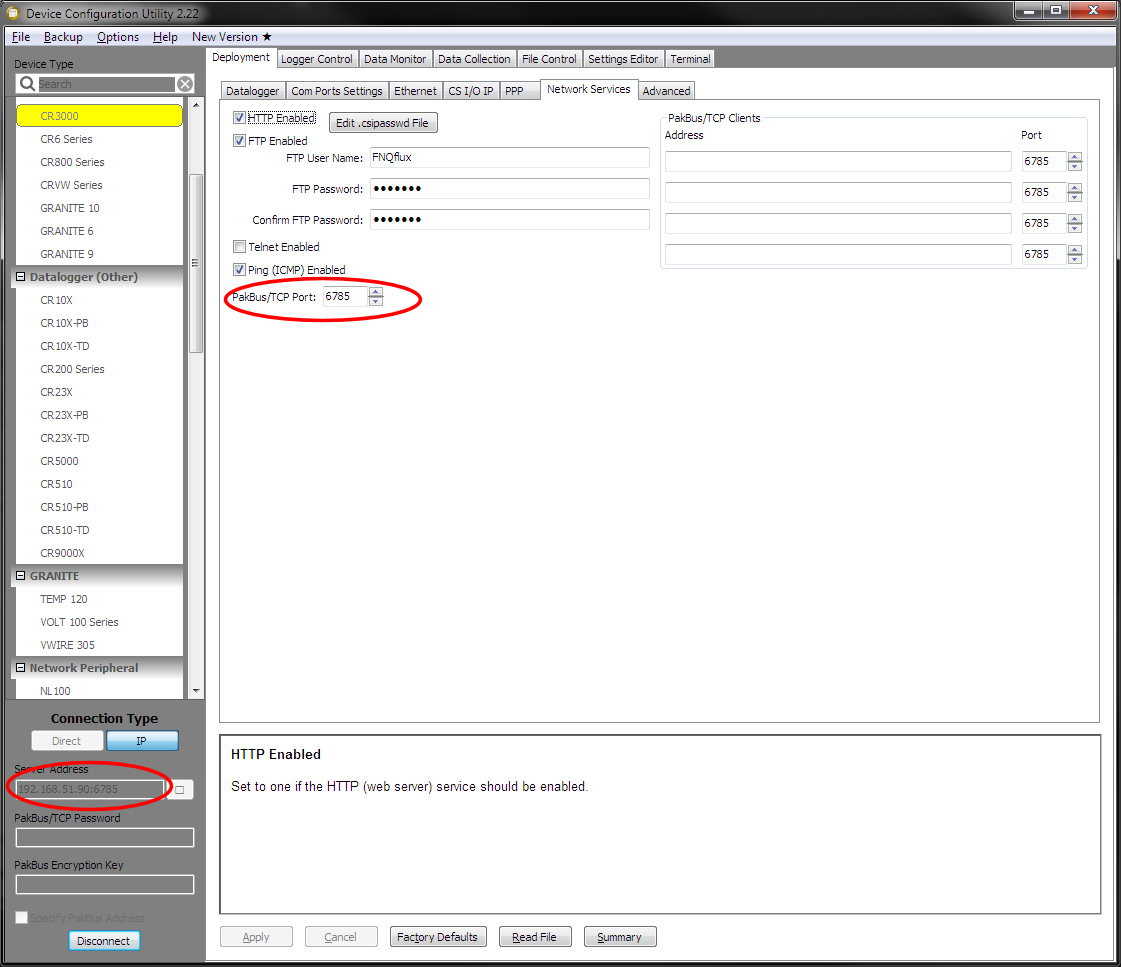
docs/images/ovpn_images/ovpn_modem_setup_instructions_ML_html_13c33a20.jpg
