MarkusLoew/OzFluxtowerhandbook/docs/images/ovpn_images/ovpn_modem_setup_instructions_ML_html_21c86555.png

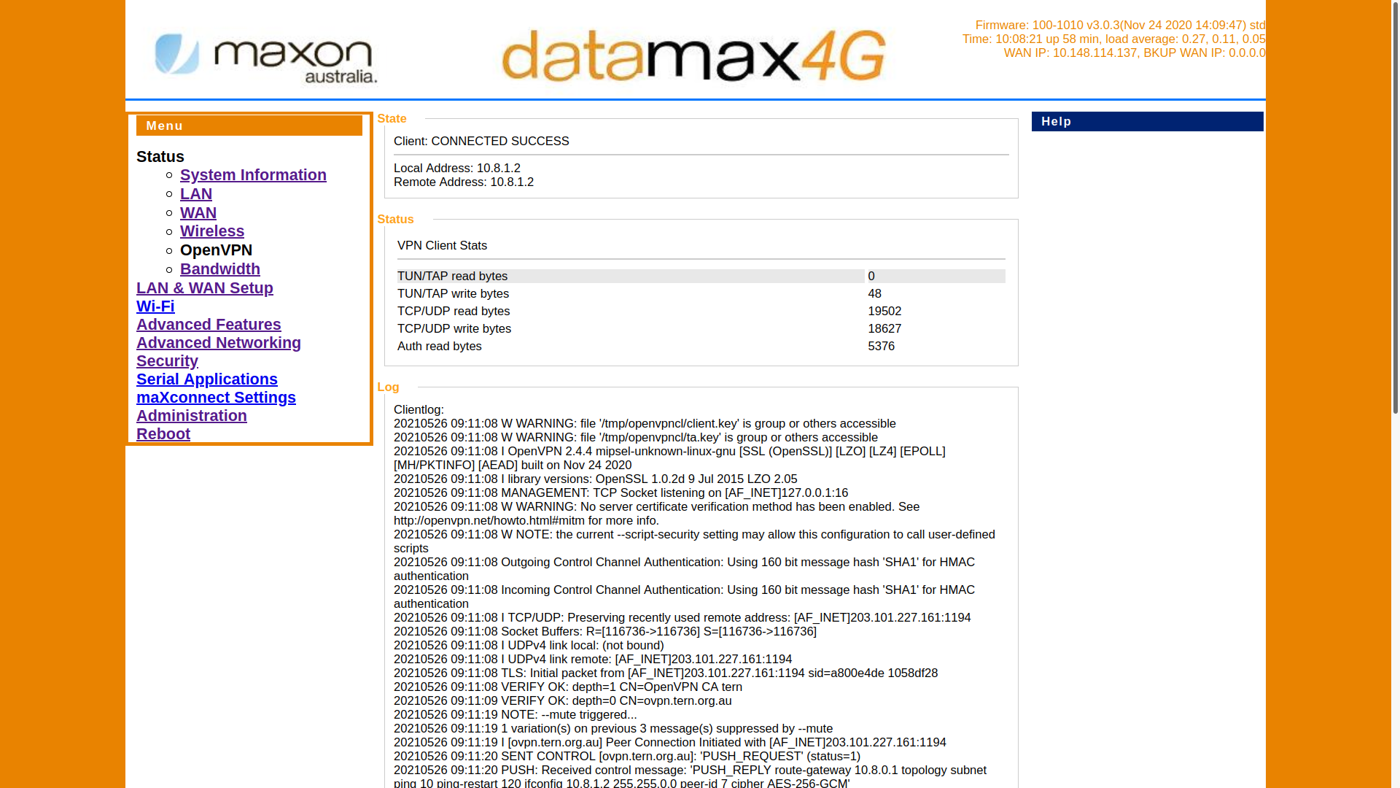
docs/images/ovpn_images/ovpn_modem_setup_instructions_ML_html_21c86555.png
