MarkusLoew/OzFluxtowerhandbook/docs/images/ovpn_images/ovpn_modem_setup_instructions_ML_html_93dbaff4.png

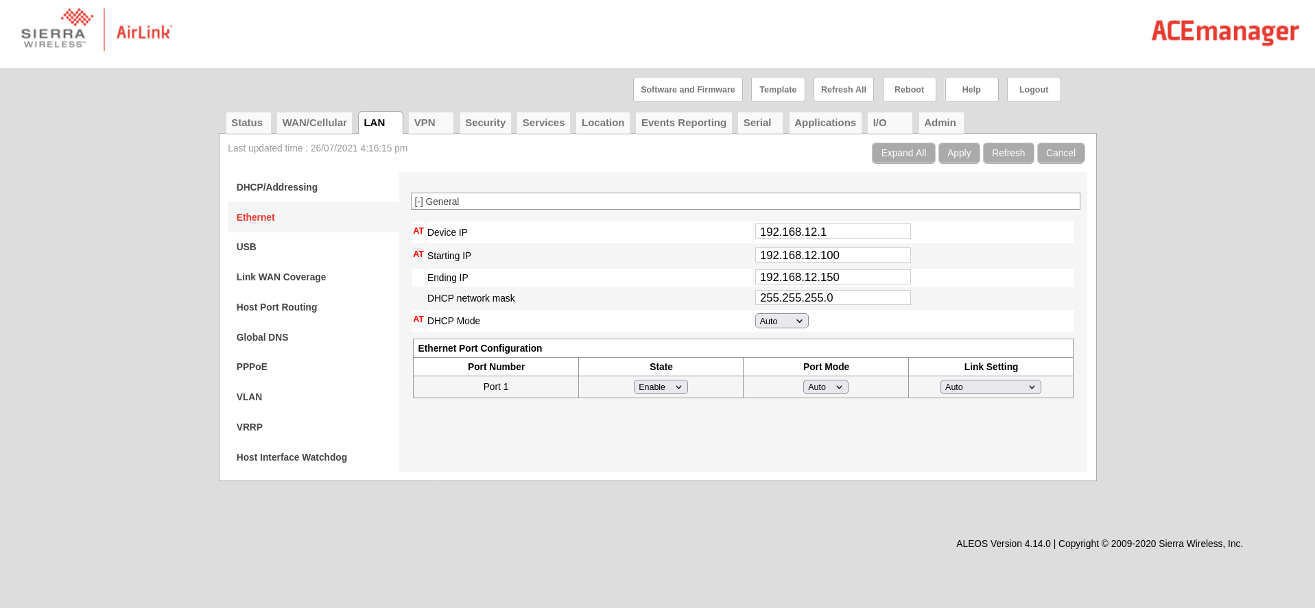
docs/images/ovpn_images/ovpn_modem_setup_instructions_ML_html_93dbaff4.png
