MarkusLoew/OzFluxtowerhandbook/docs/images/ovpn_images/ovpn_modem_setup_instructions_ML_html_621cb8a.png

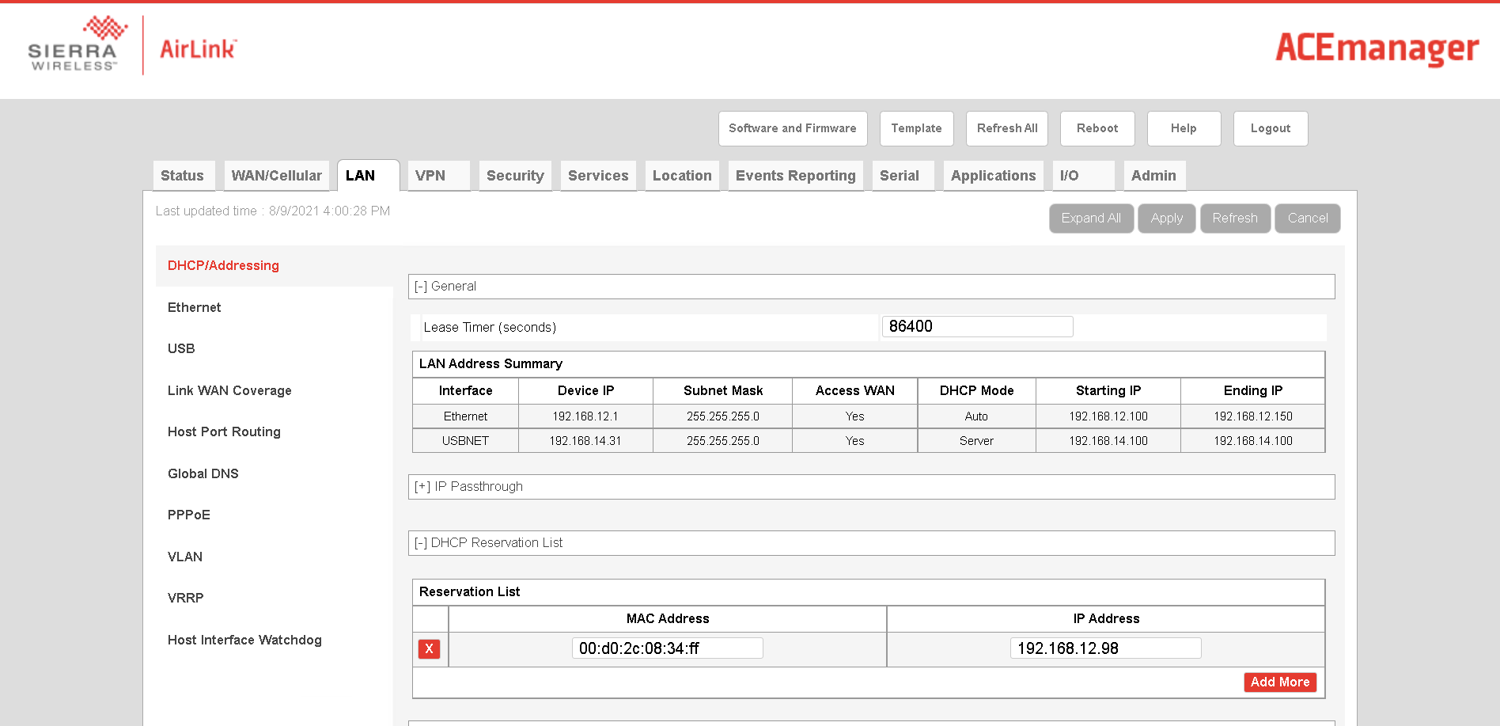
docs/images/ovpn_images/ovpn_modem_setup_instructions_ML_html_621cb8a.png
