MarkusLoew/OzFluxtowerhandbook/docs/images/ovpn_images/ovpn_modem_setup_instructions_ML_html_96095c48.jpg

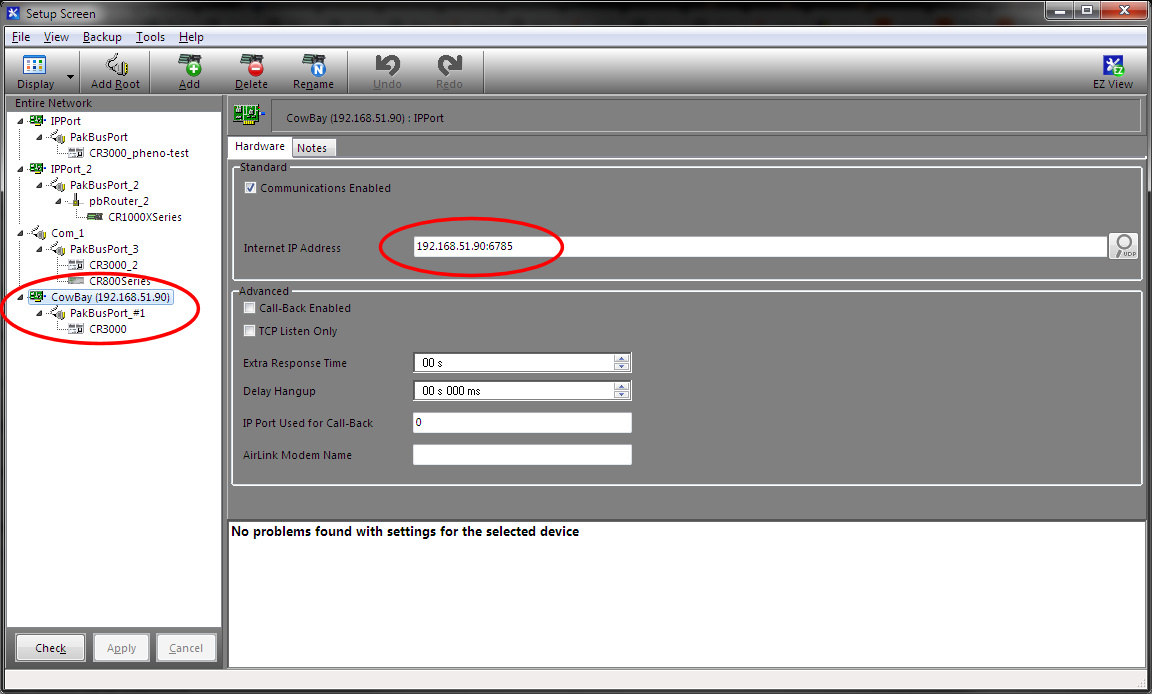
docs/images/ovpn_images/ovpn_modem_setup_instructions_ML_html_96095c48.jpg
