MarkusLoew/OzFluxtowerhandbook/docs/images/ovpn_images/ovpn_modem_setup_instructions_ML_html_bf34a289.png

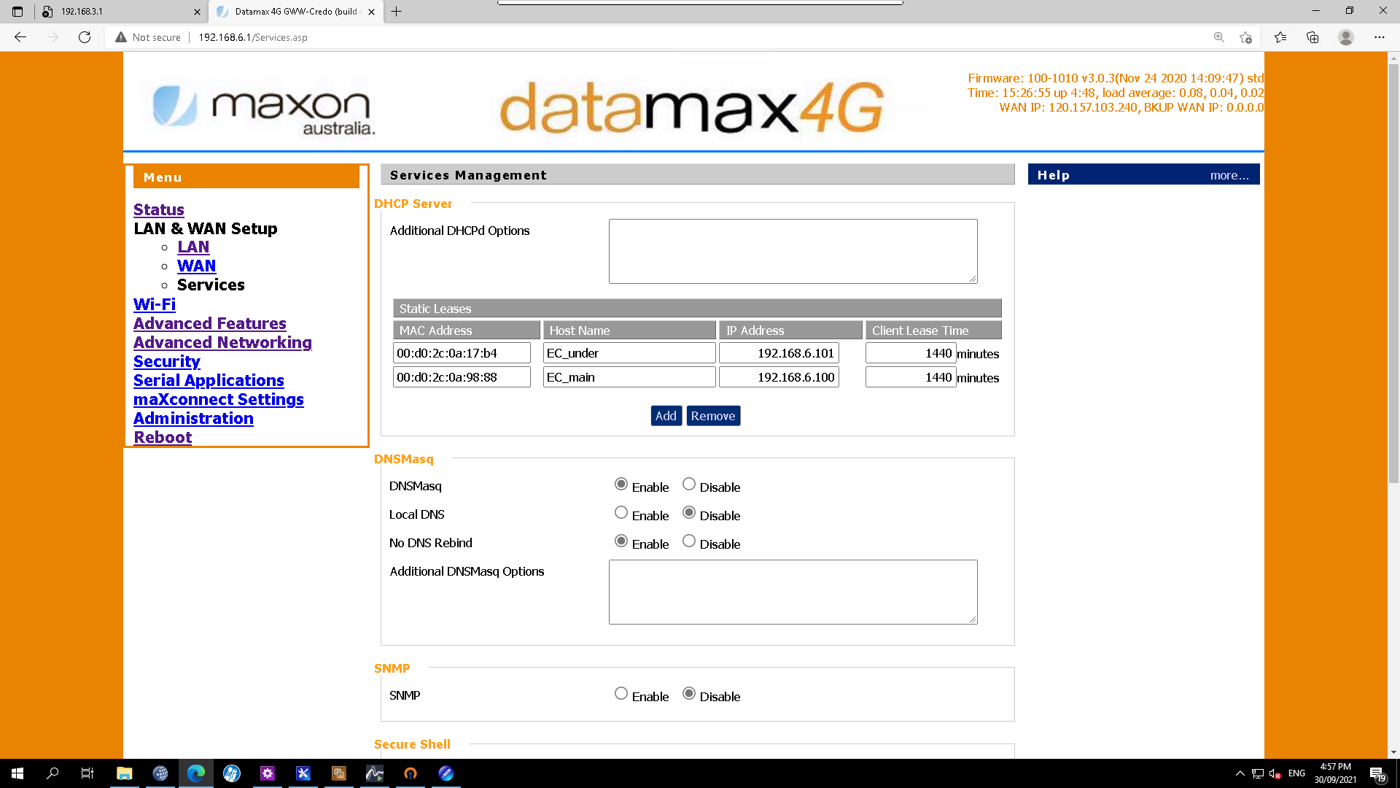
docs/images/ovpn_images/ovpn_modem_setup_instructions_ML_html_bf34a289.png
