MarkusLoew/OzFluxtowerhandbook/docs/images/ovpn_images/ovpn_modem_setup_instructions_ML_html_db8592fa.png

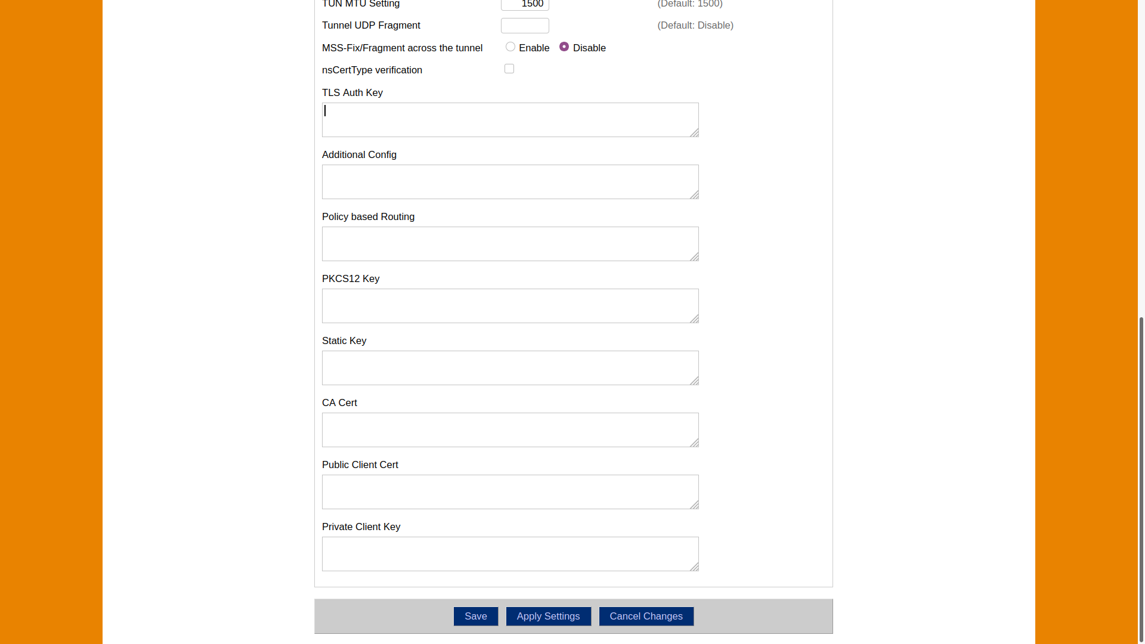
docs/images/ovpn_images/ovpn_modem_setup_instructions_ML_html_db8592fa.png
