MarkusLoew/OzFluxtowerhandbook/docs/images/ovpn_images/ovpn_modem_setup_instructions_ML_html_e48a7d67.png

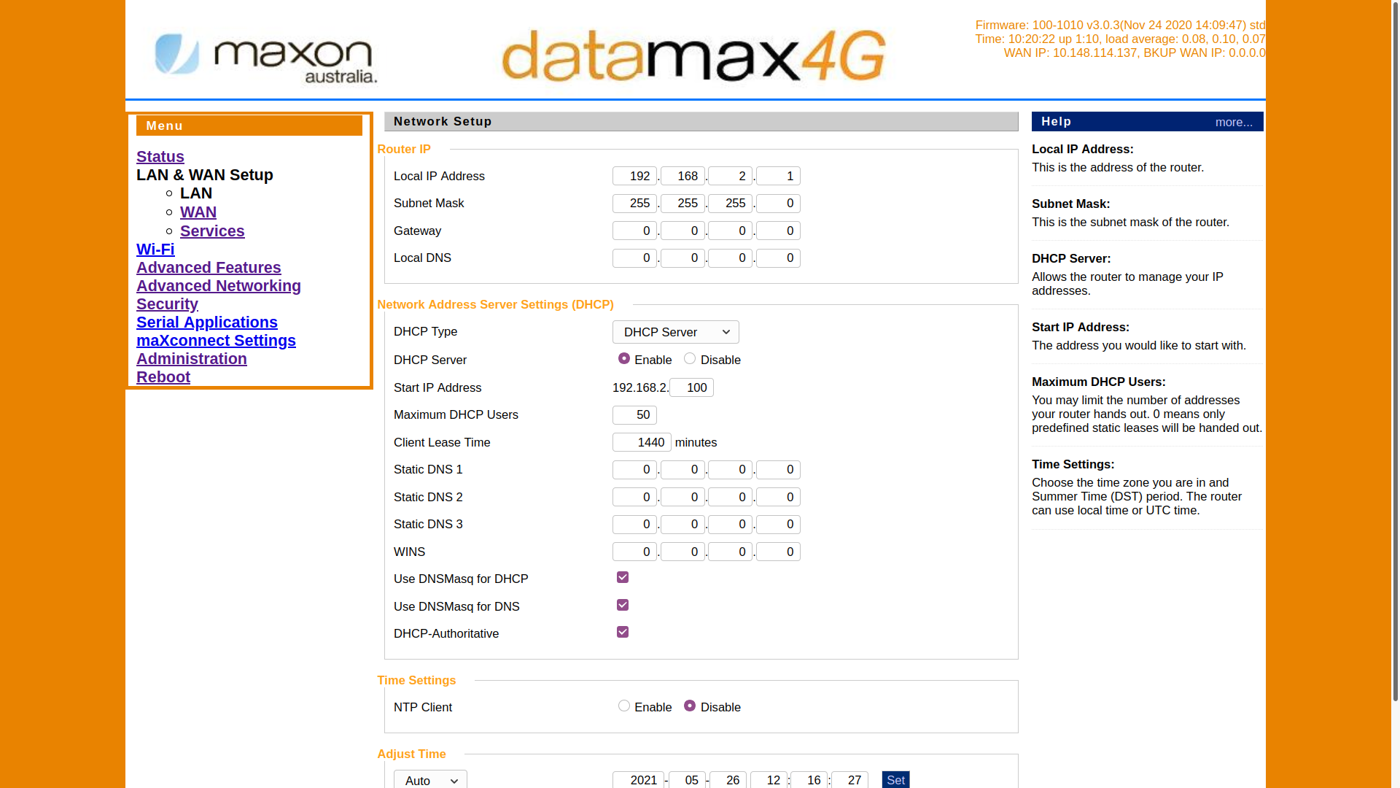
docs/images/ovpn_images/ovpn_modem_setup_instructions_ML_html_e48a7d67.png
