MarkusLoew/OzFluxtowerhandbook/docs/images/ovpn_images/ovpn_modem_setup_instructions_ML_html_fb59a2d7.png

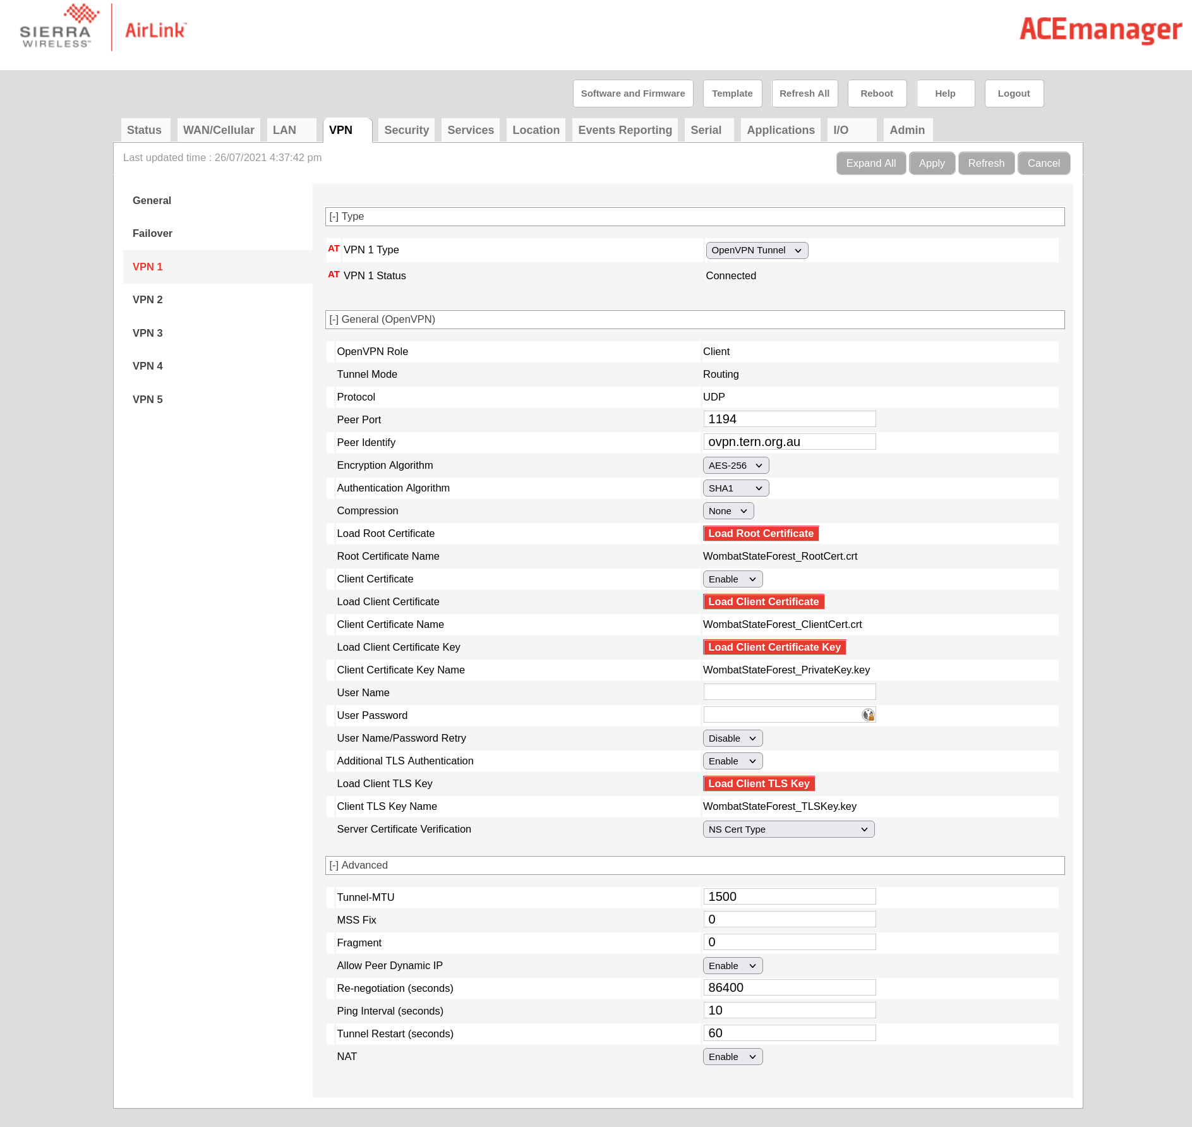
docs/images/ovpn_images/ovpn_modem_setup_instructions_ML_html_fb59a2d7.png
