MarkusLoew/OzFluxtowerhandbook/images/ovpn_images/Campbell_Loggernet_Connect_DNS_setup.png

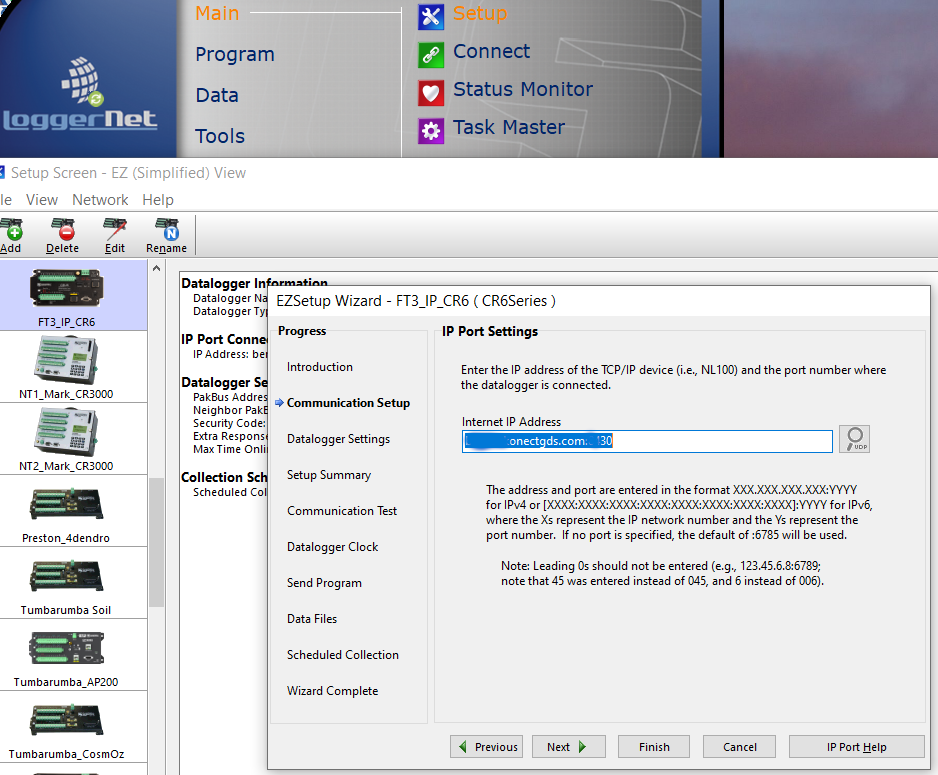
images/ovpn_images/Campbell_Loggernet_Connect_DNS_setup.png
