MarkusLoew/OzFluxtowerhandbook/images/ovpn_images/Campbell_Loggernet_Setup_Neighbour.png

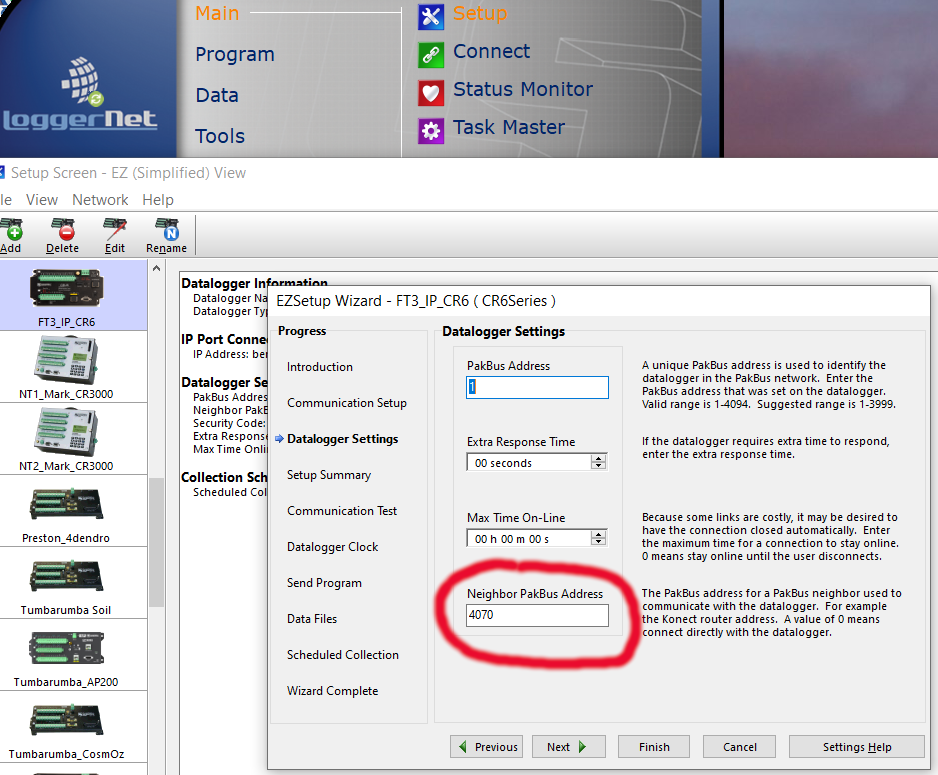
images/ovpn_images/Campbell_Loggernet_Setup_Neighbour.png
