MarkusLoew/OzFluxtowerhandbook/images/calibration/check_zero_PXL_20260218_050910916.jpg

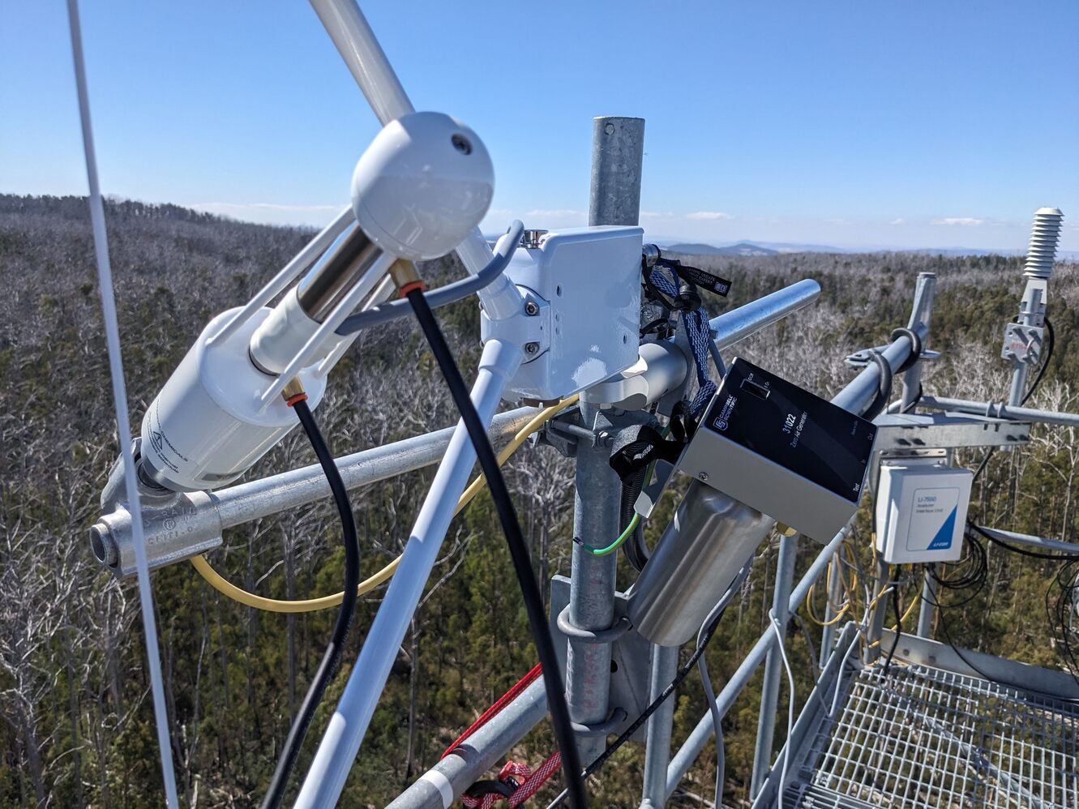
images/calibration/check_zero_PXL_20260218_050910916.jpg
