MarkusLoew/OzFluxtowerhandbook/images/calibration/check_zero_PXL_20260402_005845782.jpg

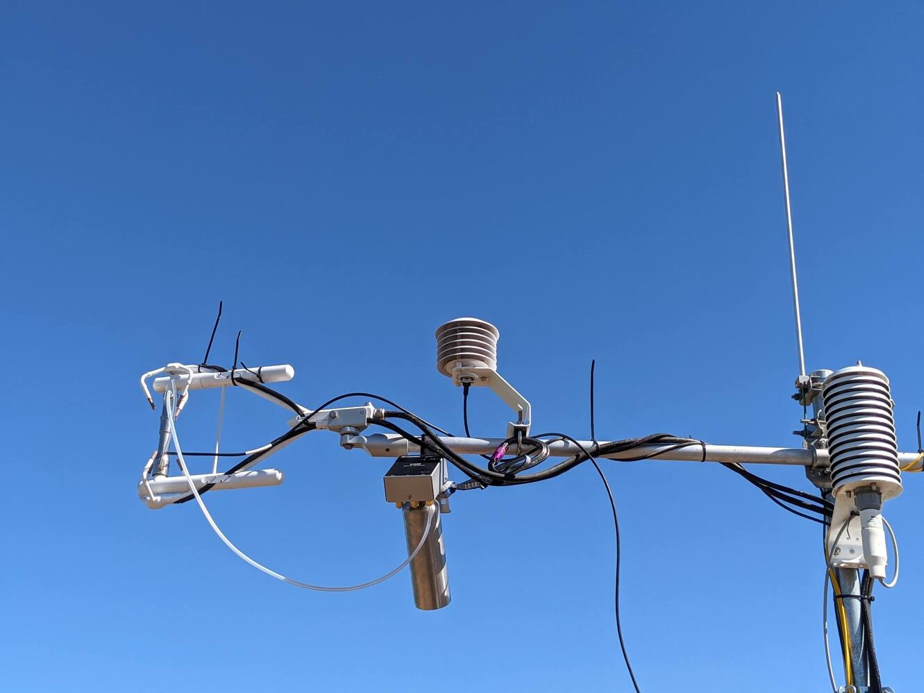
images/calibration/check_zero_PXL_20260402_005845782.jpg
