MarkusLoew/OzFluxtowerhandbook/(commit log)

2026-03-26 Initial commit: Add Quarto site for tower infrastructure wiki with pages on tower types, climbing/rigging, enclosures, and home, including images and rendered site output
2026-03-26 Wiring update
2026-03-27 Enclosure change
2026-03-30 Wiring example
2026-03-30 Wiring photo
2026-03-30 SDI12 wiring
2026-04-09 modem bracket
    [Dualmax_modem_panel_mount_Loew.stl]
2026-04-10 Power system
2026-04-10 Power updates
2026-04-17 Calibration updates
2026-07-23 Axis cameras
2026-07-23 Camera updates
2026-08-28 Camera updates, tips, tricks
2026-10-05 Phenocam power use update
2026-10-06 Battery details
2026-10-06 Battery box
2026-10-06 Power budget calculator
2026-10-06 Battery box details
